0BAB1/HOLY_CORE_COURSE/3_perf_edition/hc_lib/readme.md

# HOLY CORE LIBRARY

This folder contains holy core's utilities drivers to do the very basic stuff. Mainly printing through UART and defining the current SoC depending on what you put on the FPGA.

You will need to build by simply running `make`.

Prerequisites:

- riscv toolchain (32 bits)
- make
