0BAB1/HOLY_CORE_COURSE/3_perf_edition/example_programs/hello_world_screen/readme.md

# Hello world (screen) BRH 12/25

This exmaple app is an exmaple to develop HOLY DRIVERS for a TFT 2.8" SPI screen.
