0BAB1/HOLY_CORE_COURSE/3_perf_edition/example_programs/hello_world_screen/tos.png

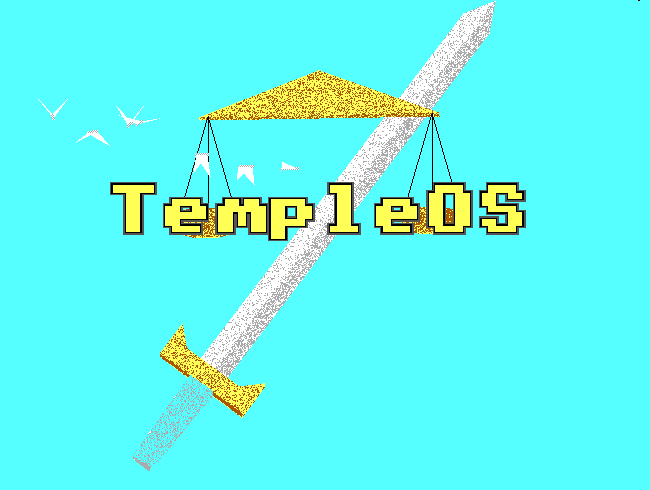
3_perf_edition/example_programs/hello_world_screen/tos.png
