0BAB1/HOLY_CORE_COURSE/user_docs/docs/images/Complete_single_cycle.png

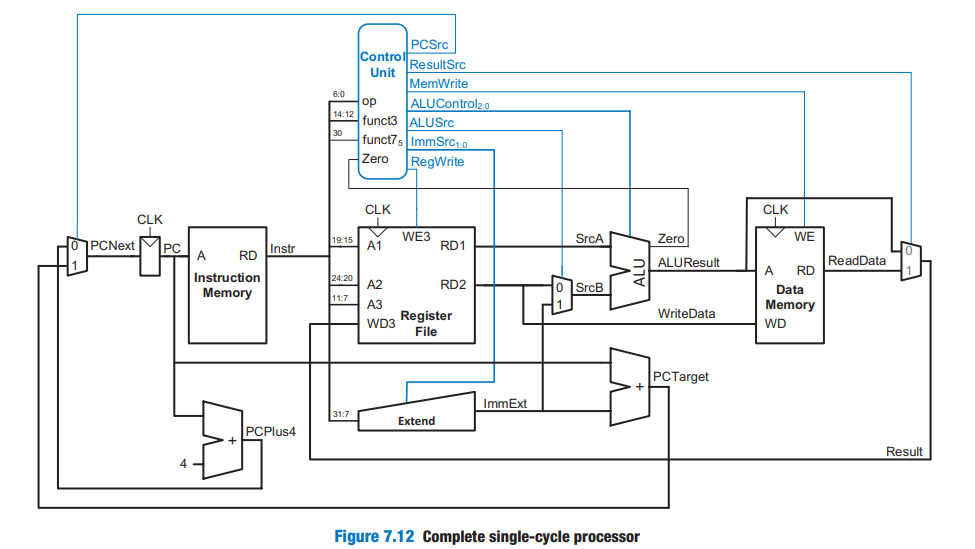
user_docs/docs/images/Complete_single_cycle.png
