0BAB1/HOLY_CORE_COURSE/user_docs/docs/images/f3_to_we_decode.png

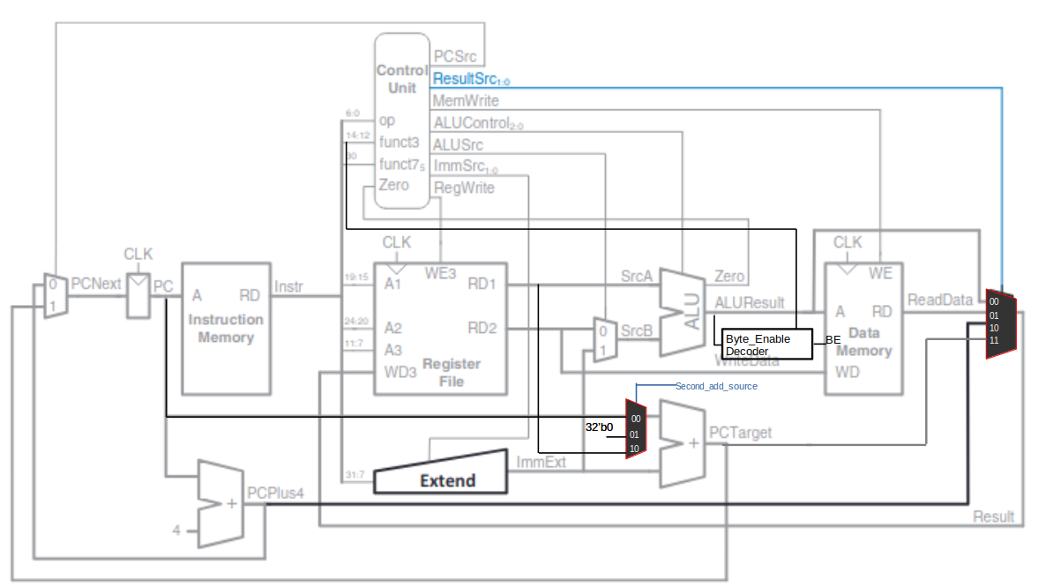
user_docs/docs/images/f3_to_we_decode.png
