0BAB1/HOLY_CORE_COURSE/user_docs/docs/images/holy_SoC.png

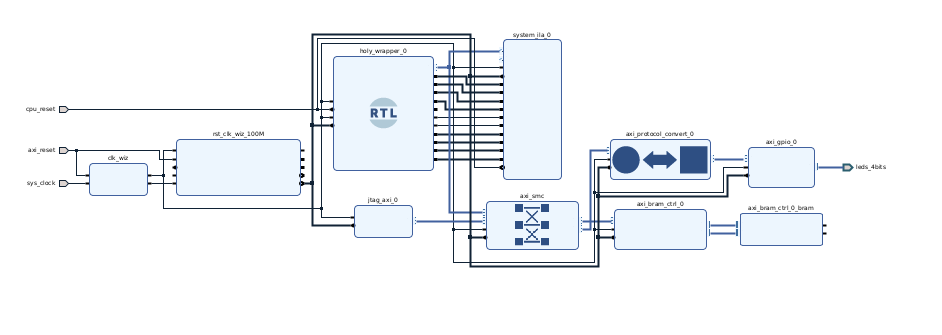
user_docs/docs/images/holy_SoC.png
