0BAB1/HOLY_CORE_COURSE/user_docs/docs/images/RV32_base_types.png

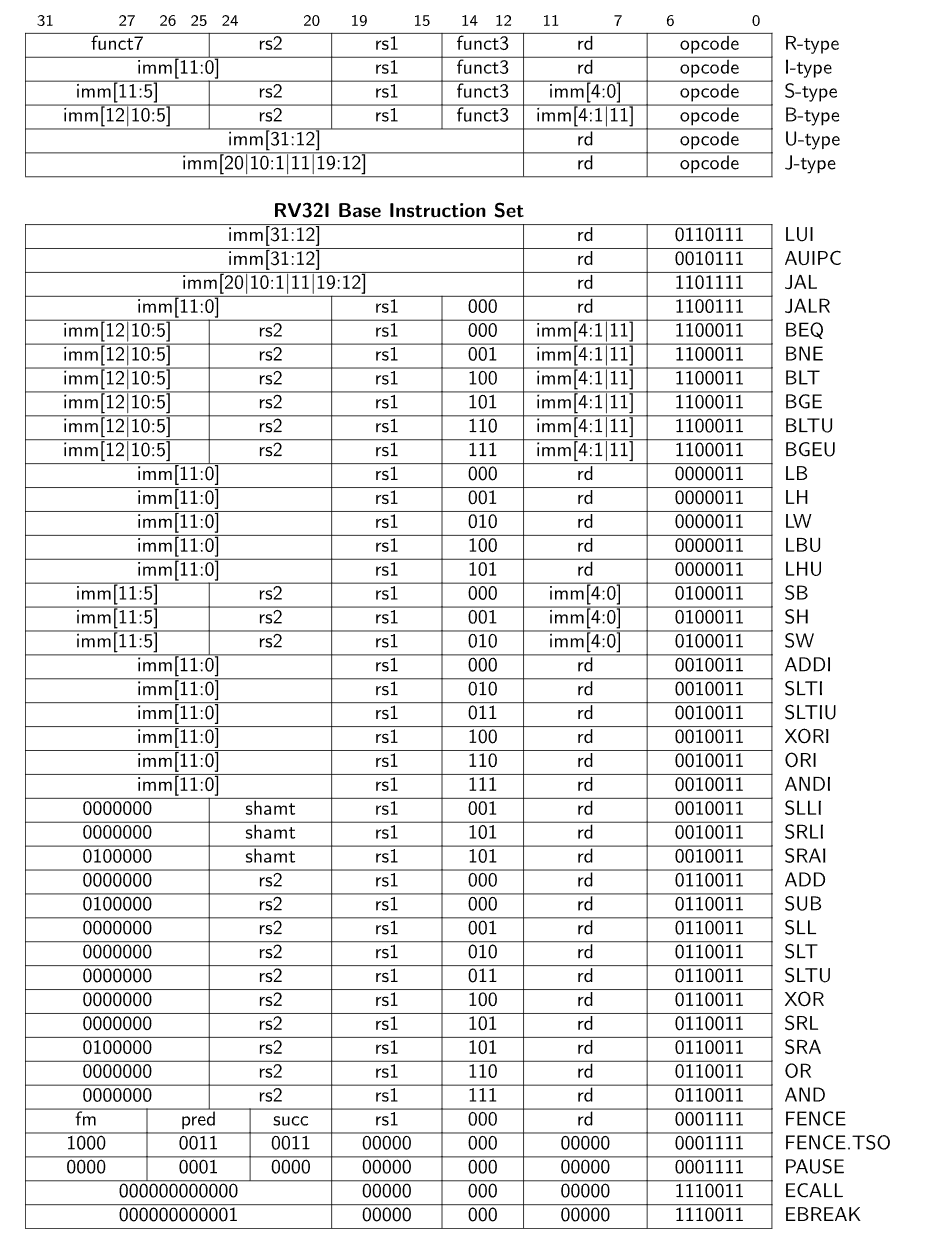
user_docs/docs/images/RV32_base_types.png
