0BAB1/HOLY_CORE_COURSE/user_docs/docs/images/todo.png

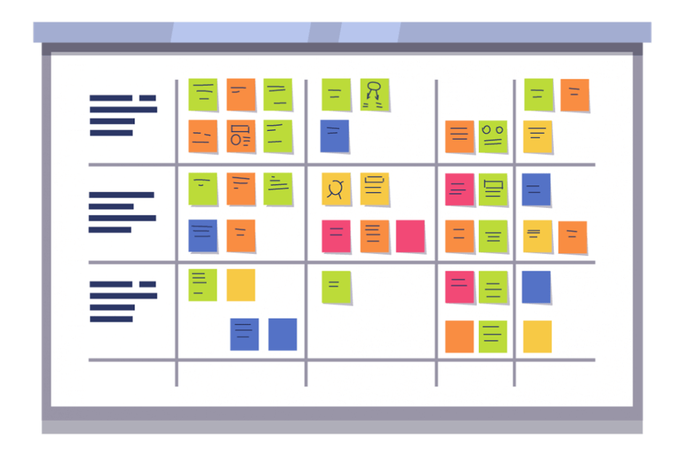
user_docs/docs/images/todo.png
