0BAB1/HOLY_CORE_COURSE/(threads)

Thread 6 (2025-01-05):

Errors in test run related to looping

gnudeep, 2025-01-05:
I want run test_runner.py on my Ubuntu 20.24 machine. When I try to run the TB I get the following error.

%Error-BLKLOOPINIT: /home/ubuntu/works/holy-core/HOLY_CORE_COURSE/single_cycle_edition/src/memory.sv:42:20: Unsupported: Delayed assignment to array inside for loops (non-delayed is ok - see docs)
   42 |             mem[i] <= 32'd0;
      |                    ^~
                    ... For error description see https://verilator.org/warn/BLKLOOPINIT?v=5.020
%Error: Exiting due to 1 error(s)
        ... See the manual at https://verilator.org/verilator_doc.html for more assistance.
Process 'perl' terminated with error 1

0BAB1, 2025-01-05:
Oh.. weird.

If you are working on the early stages of single cycle edition, using icarus verilog instead of verilator may do the trick.

To do so, replace the simulator in the cocotb makefile. Here is some guidance : https://docs.cocotb.org/en/stable/quickstart.html#creating-a-makefile

You can then switch back to verilator in the later stages of the single cycle edition.

Closed 2025-09-04.
