0BAB1/HOLY_CORE_COURSE/0_single_cycle_edition/src/control.sv

/*
* HOLY CORE CONTROL UNIT
*
* BRH 10/24
*
* Generic control unit. Refer to the schematics.
*/

`timescale 1ns/1ps

module control (
    input  logic [6:0] op,
    input  logic [2:0] func3,
    input  logic [6:0] func7,
    input  logic       alu_zero,
    input  logic       alu_last_bit,
    output logic [3:0] alu_control,
    output logic [2:0] imm_source,
    output logic       mem_write,
    output logic       reg_write,
    output logic       alu_source,
    output logic [1:0] write_back_source,
    output logic       pc_source,
    output logic [1:0] second_add_source
);

import holy_core_pkg::*;

/**
* MAIN DECODER
*/

logic [1:0] alu_op;
logic branch;
logic jump;

always_comb begin

    // Default assignments to prevent latch inference.
    reg_write = 1'b0;
    mem_write = 1'b0;
    alu_op = 2'b00;
    alu_source = 1'b0;
    imm_source = 3'b000;
    write_back_source = 2'b00;
    second_add_source = 2'b00;
    branch = 1'b0;
    jump = 1'b0;

    case (op)
        // I-type
        OPCODE_I_TYPE_LOAD : begin
            reg_write = 1'b1;
            imm_source = 3'b000;
            mem_write = 1'b0;
            alu_op = 2'b00;
            alu_source = 1'b1; //imm
            write_back_source =2'b01; //memory_read
            branch = 1'b0;
            jump = 1'b0;
        end
        // ALU I-type
        OPCODE_I_TYPE_ALU : begin
            imm_source = 3'b000;
            alu_source = 1'b1; //imm
            mem_write = 1'b0;
            alu_op = 2'b10;
            write_back_source = 2'b00; //alu_result
            branch = 1'b0;
            jump = 1'b0;
            // If we have a shift with a constant to handle, we have to invalidate writes for
            // instructions that does not have a well-formated immediate with "f7" and a 5bits shamt
            // ie :
            // - 7 upper bits are interpreted as a "f7", ony valid for a restricted slection tested below
            // - 5 lower as shamt (because max shift is 32bits and 2^5 = 32).
            if(func3 == F3_SLL)begin
                // slli only accept f7 7'b0000000
                reg_write = (func7 == F7_SLL_SRL) ? 1'b1 : 1'b0;
            end
            else if(func3 == F3_SRL_SRA)begin
                // srli only accept f7 7'b0000000
                // srai only accept f7 7'b0100000
                reg_write = (func7 == F7_SLL_SRL | func7 == F7_SRA) ? 1'b1 : 1'b0;
            end else begin
                reg_write = 1'b1;
            end
        end
        // S-Type
        OPCODE_S_TYPE : begin
            reg_write = 1'b0;
            imm_source = 3'b001;
            mem_write = 1'b1;
            alu_op = 2'b00;
            alu_source = 1'b1; //imm
            branch = 1'b0;
            jump = 1'b0;
        end
        // R-Type
        OPCODE_R_TYPE : begin
            reg_write = 1'b1;
            mem_write = 1'b0;
            alu_op = 2'b10;
            alu_source = 1'b0; //reg2
            write_back_source = 2'b00; //alu_result
            branch = 1'b0;
            jump = 1'b0;
        end
        // B-type
        OPCODE_B_TYPE : begin
            reg_write = 1'b0;
            imm_source = 3'b010;
            alu_source = 1'b0;
            mem_write = 1'b0;
            alu_op = 2'b01;
            branch = 1'b1;
            jump = 1'b0;
            second_add_source = 2'b00;
        end
        // J-type + JALR weird Hybrib
        OPCODE_J_TYPE, OPCODE_J_TYPE_JALR : begin
            reg_write = 1'b1;
            imm_source = 3'b011;
            mem_write = 1'b0;
            write_back_source = 2'b10; //pc_+4
            branch = 1'b0;
            jump = 1'b1;
            if(op[3]) begin// jal
                second_add_source = 2'b00;
                imm_source = 3'b011;
            end
            else if (~op[3]) begin // jalr
                second_add_source = 2'b10;
                imm_source = 3'b000;
            end
        end
        // U-type
        OPCODE_U_TYPE_LUI, OPCODE_U_TYPE_AUIPC : begin
            imm_source = 3'b100;
            mem_write = 1'b0;
            reg_write = 1'b1;
            write_back_source = 2'b11;
            branch = 1'b0;
            jump = 1'b0;
            case(op[5])
                1'b1 : second_add_source = 2'b01; // lui
                1'b0 : second_add_source = 2'b00; // auipc
            endcase
        end
        // EVERYTHING ELSE
        default: $display("Unknown/Unsupported OP CODE !");
    endcase
end

/**
* ALU DECODER
*/

always_comb begin

    // Default to ADD, prevents latch inference and avoids undefined alu_control value.
    alu_control = ALU_ADD;

    case (alu_op)
        // LW, SW
        ALU_OP_LOAD_STORE : alu_control = ALU_ADD;
        // R-Types, I-types
        ALU_OP_MATH : begin
            case (func3)
                // ADD (and later SUB with a different F7)
                F3_ADD_SUB : begin
                    // 2 scenarios here :
                    // - R-TYPE : either add or sub and we need to a check for that
                    // - I-Type : aadi -> we use add arithmetic
                    if(op == 7'b0110011) begin // R-type
                        alu_control = (func7 == F7_SUB)? ALU_SUB : ALU_ADD;
                    end else begin // I-Type
                        alu_control = ALU_ADD;
                    end
                end
                // AND
                F3_AND : alu_control = ALU_AND;
                // OR
                F3_OR : alu_control = ALU_OR;
                // SLT, SLTI
                F3_SLT: alu_control = ALU_SLT;
                // SLTU, SLTIU
                F3_SLTU : alu_control = ALU_SLTU;
                // XOR
                F3_XOR : alu_control = ALU_XOR;
                // SLL
                F3_SLL : alu_control = ALU_SLL;
                // SRL, SRA
                F3_SRL_SRA : begin
                    if(func7 == F7_SLL_SRL) begin
                        alu_control = ALU_SRL; // srl
                    end else if (func7 == F7_SRA) begin
                        alu_control = ALU_SRA; // sra
                    end
                end
            endcase
        end
        // BRANCHES
        ALU_OP_BRANCHES : begin
            case (func3)
                // BEQ, BNE
                F3_BEQ, F3_BNE : alu_control = ALU_SUB;
                // BLT, BGE
                F3_BLT, F3_BGE : alu_control = ALU_SLT;
                // BLTU, BGEU
                F3_BLTU, F3_BGEU : alu_control = ALU_SLTU;
                default : ;
            endcase
        end
        default : ;
    endcase
end

/**
* PC_Source
*/

logic assert_branch;

always_comb begin : branch_logic_decode
    case (func3)
        // BEQ
        F3_BEQ : assert_branch = alu_zero & branch;
        // BLT, BLTU
        F3_BLT, F3_BLTU : assert_branch = alu_last_bit & branch;
        // BNE
        F3_BNE : assert_branch = ~alu_zero & branch;
        // BGE, BGEU
        F3_BGE, F3_BGEU : assert_branch = ~alu_last_bit & branch;
        default : assert_branch = 1'b0;
    endcase
end

assign pc_source = assert_branch | jump;
    
endmodule
