0BAB1/HOLY_CORE_COURSE/3_perf_edition/src/holy_data_cache.sv

/** DATA CACHE MODULE
*
*   Author : BRH
*   Project : Holy Core Perf Edition
*   Description : A 2 way N sets, set-associative cache.
*                 Implementing AXI to request data from outside main memory.
*                 With a CPU handshake interface for OPTIMAL robusteness.
*                 The goal is to allow the user to connect its own memory on FPGA.
*                 It also supports non cachable ranges, which the use can set
*                 using CSRs.
*
*                 Goal is to implement cache as BRAM for optimal perfs
*                 Target : Xilinx FPGAs.
*
*   Created 11/25
*   Refactored: Separated ways into distinct 2D BRAMs for proper inference
*
*   10/26 - Flush fixes:
*     1. Flush write-back now gates the BRAM read on axi.wready, like the
*        normal eviction path (data was shifted / corrupted under AXI
*        back-pressure).
*     2. Flush only writes back lines that are VALID AND DIRTY (clean lines
*        were written back too, overwriting RAM changed behind the cache,
*        e.g. by a debugger load).
*     3. A flushed line is marked clean (dirty = 0) once its write response
*        is OK. With FLUSH_INVALIDATE = 1, the whole cache is also
*        invalidated when the flush completes.
*     4. Flush sequencing rewritten: every line is handled, then FLUSH_NEXT
*        advances or finishes (the last line could be written back twice).
*/

import holy_core_pkg::*;

module holy_data_cache #(
    parameter WORDS_PER_LINE = 16,
    parameter NUM_SETS = 8,
    // 0: flush = write back dirty lines, keep them valid (now clean)
    // 1: flush = write back dirty lines, then invalidate the whole cache
    parameter bit FLUSH_INVALIDATE = 1'b1,
    // MODIFYING THE FOLLOWING IS NOT SUPPORTED. 
    parameter NUM_WAYS = 2 
)(
    input logic clk,
    input logic rst_n,

    // CPU Interface
    input logic [31:0]  address,
    input logic [31:0]  write_data,
    // handshake
    input logic         req_valid,
    output logic        req_ready,
    input logic         req_write, // 0->R // 1->W
    input logic [3:0]   byte_enable,
    // read out
    output logic [31:0] read_data,
    output logic        read_valid,
    input logic         read_ack,

    // incomming CSR Orders
    input logic         csr_flush_order,

    // AXI Interface for external requests
    axi_if.master axi,

    // State informations for arbitrer
    output cache_state_t cache_state
);
    // =======================
    // CPU FRONTEND : HANDSHAKE CONTROL
    // =======================

    // Ready when idle (and not flushing)
    assign req_ready = (state == IDLE) && ~(csr_flush_order && ~csr_flushing_done);
    
    // flag accepted request for state transition
    logic req_accepted;
    assign req_accepted = req_valid && req_ready;

    // Request latch on miss: in case of a miss, the cache needs to remember 
    // the original missed request to fulfill it once it has moved data around
    logic                           pending_write, next_pending_write;
    logic [31:0]                    pending_addr, next_pending_addr;
    logic [31:0]                    pending_data, next_pending_data;
    logic [3:0]                     pending_be, next_pending_be;
    logic [SET_INDEX_BITS-1:0]      pending_set, next_pending_set;
    logic [WORD_OFFSET_BITS-1:0]    pending_word_offset, next_pending_word_offset;
    logic [TAG_BITS-1:0]            pending_tag, next_pending_tag;
    // Separate register to determine wether the upcomming READ OK results from a
    // missed request.
    logic                           pending_read, next_pending_read;

    // Hit latches are redundant, but kept because... yeah idk
    logic pending_hit_way, next_pending_hit_way;

    assign read_valid = (state == READ_OK);

    // =======================
    // ADDRESS BREAKDOWN
    // =======================
    // Address format: [TAG | SET_INDEX | WORD_OFFSET | BYTE_OFFSET]
    // 32 bits total:
    //   - Byte offset: 2 bits (4 bytes per word)
    //   - Word offset: 4 bits (16 words per line)
    //   - Set index: 3 bits (8 sets)
    //   - Tag: 23 bits (remaining)
    
    localparam WAYS_BITS = $clog2(NUM_WAYS);
    localparam BYTE_OFFSET_BITS = 2;
    localparam WORD_OFFSET_BITS = $clog2(WORDS_PER_LINE);
    localparam SET_INDEX_BITS   = $clog2(NUM_SETS);
    localparam TAG_BITS         = 32 - BYTE_OFFSET_BITS - WORD_OFFSET_BITS - SET_INDEX_BITS;

    // warning free markers for loops
    localparam LAST_WORD = WORDS_PER_LINE - 1;
    localparam LAST_SET = NUM_SETS - 1;
    
    wire [TAG_BITS-1:0]         req_tag;
    wire [SET_INDEX_BITS-1:0]   req_set;
    wire [WORD_OFFSET_BITS-1:0] req_word_offset;
    
    assign req_tag         = address[31:31-TAG_BITS+1];
    assign req_set         = address[BYTE_OFFSET_BITS+WORD_OFFSET_BITS +: SET_INDEX_BITS];
    assign req_word_offset = address[BYTE_OFFSET_BITS +: WORD_OFFSET_BITS];

    // =======================
    // BRAM PORTS SIGNALS
    // =======================
    
    // Enable signals for each way
    logic bram_we_way0, bram_we_way1;
    logic bram_re_way0, bram_re_way1;
    // to flag when read recieve is fully over
    logic bram_write_complete, next_bram_write_complete;
    
    // Address signals for BRAM access
    logic [SET_INDEX_BITS-1:0]   bram_set_addr;
    logic [WORD_OFFSET_BITS-1:0] bram_word_addr;
    
    // R/W data for BRAMs
    logic [31:0] bram_wdata;
    logic [3:0]  bram_be;
    logic [31:0] rdata_way0, rdata_way1;
    logic [31:0] bram_rdata;

    // =======================
    // Data slots declaration - SEPARATED WAYS FOR BRAM INFERENCE
    // =======================

    // Cache storage: 2 separate BRAMs, one per way
    // Each BRAM: NUM_SETS × WORDS_PER_LINE words

    // Way 0 BRAM
    cache_bram_way #(
    .NUM_SETS(NUM_SETS),
    .WORDS_PER_LINE(WORDS_PER_LINE)
    ) bram_way0 (
        .clk(clk),
        .we(bram_we_way0),
        .be(bram_be),
        .set_addr(bram_set_addr),
        .word_addr(bram_word_addr),
        .wdata(bram_wdata),
        .re(bram_re_way0),
        .rdata(rdata_way0)
    );

    // Way 1 BRAM
    cache_bram_way #(
    .NUM_SETS(NUM_SETS),
    .WORDS_PER_LINE(WORDS_PER_LINE)
    ) bram_way1 (
        .clk(clk),
        .we(bram_we_way1),
        .be(bram_be),
        .set_addr(bram_set_addr),
        .word_addr(bram_word_addr),
        .wdata(bram_wdata),
        .re(bram_re_way1),
        .rdata(rdata_way1)
    );

    // Metadata remains as before
    logic [TAG_BITS-1:0] cache_tags  [NUM_WAYS-1:0][NUM_SETS-1:0];
    logic                cache_valid [NUM_WAYS-1:0][NUM_SETS-1:0];
    logic                cache_dirty [NUM_WAYS-1:0][NUM_SETS-1:0];

    // lru = least recently used, decides which way will 
    logic lru_bits [NUM_SETS-1:0];

    // Signals for cache access
    logic hit_way0, hit_way1, hit;
    logic [NUM_WAYS-1:0] way_hit;
    logic hit_way_select;
    logic victim_way;

    // Control signals
    logic csr_flushing, next_csr_flushing;
    logic csr_flushing_done, next_csr_flushing_done;

    // =======================
    // HIT DETECTION COMB
    // =======================

    assign hit_way0 = cache_valid[0][req_set] && (cache_tags[0][req_set] == req_tag);
    assign hit_way1 = cache_valid[1][req_set] && (cache_tags[1][req_set] == req_tag);
    assign hit = hit_way0 || hit_way1;
    assign hit_way_select = hit_way1; // 0 if way0 hits, 1 if way1 hits

    // Victim selection for replacement (use LRU)
    assign victim_way = lru_bits[req_set];

    // =======================
    // CACHE LOGIC
    // =======================
    cache_state_t state, next_state;

    // Current way being serviced
    logic current_way, next_current_way;
    // flush indicators
    logic [WAYS_BITS-1:0]           flush_way, next_flush_way;
    logic [SET_INDEX_BITS-1:0]      flush_set, next_flush_set;

    // Word pointer for burst transfers
    logic [WORD_OFFSET_BITS-1:0]    word_ptr, next_word_ptr;
    // This is a quick temp fix to keep rack of words sent during SENDING W DATA
    // state, I can't use word ptr bcause it will overflow...
    logic [WORD_OFFSET_BITS:0]      words_sent, next_words_sent;

    // Cache valid/dirty next state
    logic [TAG_BITS-1:0] next_cache_tags  [NUM_WAYS-1:0][NUM_SETS-1:0];
    logic next_cache_valid  [NUM_WAYS-1:0][NUM_SETS-1:0];
    logic next_cache_dirty  [NUM_WAYS-1:0][NUM_SETS-1:0];
    logic next_lru_bits     [NUM_SETS-1:0];

    // bram_write_complete registers
    always_ff @(posedge clk) begin
        if (~rst_n) begin
            bram_write_complete <= 0;
        end else begin
            bram_write_complete <= next_bram_write_complete;
        end
    end

    // Mux the read data
    // We want to read when :
    //   - we are reading (read OK)
    //   - sending back data on a write back (flush or missed request)
    always_comb begin
        bram_rdata = '0;
        if(state == READ_OK) begin
            if(~pending_read) begin
                // Read was a HIT
                bram_rdata = pending_hit_way ? rdata_way1 : rdata_way0;
            end else begin
                // Read was a MISS
                bram_rdata = current_way ? rdata_way1 : rdata_way0;
            end
        end else if(state == SENDING_WRITE_DATA) begin
            if(csr_flushing) begin
                bram_rdata = flush_way ? rdata_way1 : rdata_way0;
            end else begin
                bram_rdata = current_way ? rdata_way1 : rdata_way0;
            end
        end
    end
    
    // =======================
    // BRAM CONTROL SIGNALS - ACTIVE SOURCE SELECTION
    // =======================
    
    // Determine BRAM write enables based on current operation
    always_comb begin
        // Defaults
        bram_we_way0 = 1'b0;
        bram_we_way1 = 1'b0;
        bram_re_way0 = 1'b0;
        bram_re_way1 = 1'b0;
        bram_be = 4'b0;
        bram_set_addr = req_set;
        bram_word_addr = req_word_offset;
        bram_wdata = write_data;
        
        //---------------------------
        // Write HIT on IDLE state
        //---------------------------
        if (state == IDLE && hit && req_write && req_accepted) begin
            bram_set_addr = req_set;
            bram_word_addr = req_word_offset;
            bram_wdata = write_data;
            bram_be = byte_enable;
            bram_we_way0 = hit_way0;
            bram_we_way1 = hit_way1;
        end
        
        //---------------------------
        // AXI cache line fill
        //---------------------------
        else if (state == RECEIVING_READ_DATA && axi.rvalid && axi.rready) begin
            bram_set_addr = pending_set;
            bram_word_addr = word_ptr;
            bram_wdata = axi.rdata;
            bram_be = 4'b1111;
            bram_we_way0 = (current_way == 1'b0);
            bram_we_way1 = (current_way == 1'b1);
        end

        //---------------------------
        // AXI write back : prefetch first data while sending request
        //---------------------------
        else if (state == SENDING_WRITE_REQ) begin
            if (csr_flushing) begin
                bram_set_addr = flush_set;
                bram_word_addr = '0;
                bram_re_way0 = ~flush_way;
                bram_re_way1 = flush_way;
            end else begin
                bram_set_addr = pending_set;
                bram_word_addr = '0;
                bram_re_way0 = ~current_way;
                bram_re_way1 = current_way;
            end
        end

        //---------------------------
        // AXI write back : we need to read data from BRAM to send it !
        // The BRAM read is 1 cycle late vs word_ptr: only advance the readout
        // when the slave accepts the current word (both paths).
        //---------------------------
        else if (state == SENDING_WRITE_DATA) begin
            if (csr_flushing) begin
                // FIX : same back-pressure gating as the eviction path
                bram_set_addr = flush_set;
                bram_word_addr = word_ptr;
                bram_re_way0 = axi.wready ? ~flush_way : 1'b0;
                bram_re_way1 = axi.wready ?  flush_way : 1'b0;
            end else begin
                bram_set_addr = pending_set;
                bram_word_addr = word_ptr;
                bram_re_way0 = axi.wready ? ~current_way : 1'b0;
                bram_re_way1 = axi.wready ?  current_way : 1'b0;
            end
        end
        
        // Fulfill pending write after cache line fill
        else if (state == FULFILL_PENDING_WRITE) begin
            bram_set_addr = pending_set;
            bram_word_addr = pending_word_offset;
            bram_wdata = pending_data;
            bram_be = pending_be;
            bram_we_way0 = (current_way == 1'b0);
            bram_we_way1 = (current_way == 1'b1);
        end
        
        // Read address setup
        if (next_state == READ_OK) begin
            if(hit && ~pending_read) begin
                bram_re_way0 = hit_way0;
                bram_re_way1 = hit_way1;
            end else begin
                bram_re_way0 = (current_way == 1'b0);
                bram_re_way1 = (current_way == 1'b1);
            end

            if (hit && ~pending_read) begin
                bram_set_addr = req_set;
                bram_word_addr = req_word_offset;
            end else begin
                bram_set_addr = pending_set;
                bram_word_addr = pending_word_offset;
            end
        end
    end

    // =======================
    // MAIN CLOCK DRIVEN SEQ LOGIC (METADATA ONLY)
    // =======================
    
    always_ff @(posedge clk) begin
        if (~rst_n) begin
            csr_flushing <= 1'b0;
            csr_flushing_done <= 1'b0;
            // flush reg
            flush_way <= 0;
            flush_set <= 0;
            
            // Initialize all cache lines as invalid
            for (int w = 0; w < NUM_WAYS; w++) begin
                for (int s = 0; s < NUM_SETS; s++) begin
                    cache_valid[w][s] <= 1'b0;
                    cache_dirty[w][s] <= 1'b0;
                    cache_tags[w][s] <= '0;
                end
            end
            
            // Initialize LRU bits
            for (int s = 0; s < NUM_SETS; s++) begin
                lru_bits[s] <= 1'b0;
            end

            // missed requests latches
            pending_write <= 1'b0;
            pending_addr <= '0;
            pending_data <= '0;
            pending_be <= 4'b0;
            pending_set <= '0;
            pending_word_offset <= '0;
            pending_tag <= '0;
            pending_read <= 1'b0;
            pending_hit_way <= 1'b0;
            
        end else begin
            // DEFAULT REG LATCHES
            // cache metadata
            for (int w = 0; w < NUM_WAYS; w++) begin
                for (int s = 0; s < NUM_SETS; s++) begin
                    cache_tags[w][s]  <= next_cache_tags[w][s];
                    cache_valid[w][s] <= next_cache_valid[w][s];
                    cache_dirty[w][s] <= next_cache_dirty[w][s];
                end
            end

            for (int s = 0; s < NUM_SETS; s++) begin
                lru_bits[s] <= next_lru_bits[s];
            end

            
            csr_flushing <= next_csr_flushing;
            csr_flushing_done <= next_csr_flushing_done;

            // flush reg
            flush_way <= next_flush_way;
            flush_set <= next_flush_set;

            // pending request latches
            pending_write <= next_pending_write;
            pending_addr  <= next_pending_addr;
            pending_data <= next_pending_data;
            pending_be <= next_pending_be;
            pending_set <= next_pending_set;
            pending_word_offset <= next_pending_word_offset;
            pending_tag <= next_pending_tag;
            pending_read <= next_pending_read;
            pending_hit_way <= next_pending_hit_way;

            // Handle dirty flag update on cache hit write
            if (hit && req_write && req_accepted && state == IDLE) begin
                if (hit_way0) begin
                    cache_dirty[0][req_set] <= 1'b1;
                    lru_bits[req_set] <= 1'b1; // Mark way 1 as LRU
                end else begin
                    cache_dirty[1][req_set] <= 1'b1;
                    lru_bits[req_set] <= 1'b0; // Mark way 0 as LRU
                end
            end
            
            // Update LRU on read hit (when request is accepted)
            if (hit && ~req_write && req_accepted && state == IDLE) begin
                lru_bits[req_set] <= ~hit_way_select;
            end
        end
    end

    // =======================
    // AXI FSM STATES
    // =======================

    // SEQ LOGIC
    always_ff @(posedge clk) begin
        if (~rst_n) begin
            state <= IDLE;
            word_ptr <= '0;
            words_sent <= '0;
            current_way <= 1'b0;
        end else begin
            state <= next_state;
            word_ptr <= next_word_ptr;
            current_way <= next_current_way;
            words_sent <= next_words_sent;
        end
    end

    // STATE TRANSITION / AXI MASTER LOGIC
    always_comb begin
        // State transition defaults
        next_state = state;
        next_current_way = current_way;
        next_word_ptr = word_ptr;
        next_words_sent = 0;
        
        // flush control
        next_csr_flushing = csr_flushing;
        next_csr_flushing_done = csr_flushing_done ? csr_flush_order : csr_flushing_done;
        next_flush_set = flush_set;
        next_flush_way = flush_way;
        
        // cache metadata
        next_cache_tags = cache_tags;
        next_cache_valid = cache_valid;
        next_cache_dirty = cache_dirty;
        next_lru_bits = lru_bits;
        
        // pending request latches
        next_pending_write = pending_write;
        next_pending_addr = pending_addr;
        next_pending_data = pending_data;
        next_pending_be = pending_be;
        next_pending_set = pending_set;
        next_pending_word_offset = pending_word_offset;
        next_pending_tag = pending_tag;
        next_pending_read = pending_read;
        next_pending_hit_way = pending_hit_way;

        // AXI DEFAULT
        axi.wlast = 0;
        axi.arvalid = 0;
        axi.awvalid = 0;
        axi.wvalid = 0;
        axi.bready = 0;
        axi.rready = 0;
        axi.wdata = '0;
        axi.araddr = 32'h0;
        axi.awaddr = 32'h0;

        // MISC DEFAULTS
        cache_state = state;
        read_data = 32'h0;
        next_bram_write_complete = 0;

        case (state)
            IDLE: begin
                // INIT FLUSHING PROCEDURE
                // Walk every (way, set) starting at (0, 0). Only VALID AND DIRTY
                // lines are written back; FLUSH_NEXT advances over the others.
                if (csr_flush_order && ~csr_flushing_done) begin
                    next_csr_flushing = 1'b1;
                    next_flush_set = '0;
                    next_flush_way = '0;

                    if (cache_valid[0][0] && cache_dirty[0][0]) begin
                        next_state = SENDING_WRITE_REQ;
                    end else begin
                        next_state = FLUSH_NEXT;
                    end
                end
                
                // ACCEPT MISS
                else if (req_accepted && ~hit) begin
                    // Cache miss on accepted request - determine victim way
                    next_current_way = victim_way;

                    // Latch the entire request for later fulfillment
                    next_pending_write = req_write;
                    next_pending_read = ~req_write;
                    next_pending_addr = address;
                    next_pending_data = write_data;
                    next_pending_be = byte_enable;
                    next_pending_set = req_set;
                    next_pending_word_offset = req_word_offset;
                    next_pending_tag = req_tag;
                    
                    // Check if victim line is dirty
                    if (cache_valid[victim_way][req_set] && cache_dirty[victim_way][req_set]) begin
                        next_state = SENDING_WRITE_REQ;
                    end else begin
                        next_state = SENDING_READ_REQ;
                    end
                    next_word_ptr = '0;
                end
                
                // ACCEPT HIT (READ)
                else if (hit && ~req_write && req_accepted) begin
                    next_state = READ_OK;
                    next_pending_hit_way = hit_way_select;
                end
            end
            
            SENDING_WRITE_REQ: begin
                // Write back dirty cache line
                if (csr_flushing) begin
                    axi.awaddr = {cache_tags[flush_way][flush_set], flush_set, {WORD_OFFSET_BITS{1'b0}}, 2'b00};
                end else begin
                    axi.awaddr = {cache_tags[current_way][pending_set], pending_set, {WORD_OFFSET_BITS{1'b0}}, 2'b00};
                end
                
                if (axi.awready) begin
                    next_state = SENDING_WRITE_DATA;
                    // we start at 1 because word 0 is being pre fetched
                    next_word_ptr = 1;
                end

                axi.awvalid = 1'b1;
            end

            SENDING_WRITE_DATA: begin
                next_words_sent = words_sent;
                axi.wdata = bram_rdata;
                axi.wvalid = 1'b1;
                // data is flagged as ready to send once BRAM outputs its data
                if (axi.wready) begin
                    next_word_ptr = word_ptr + 1;
                    next_words_sent = words_sent + 1;
                end
                
                // watch out ! there is a 1 cycle delay between word_ptr and the actual
                // data value associated (bram).
                if (words_sent == LAST_WORD[WORD_OFFSET_BITS:0]) begin
                    axi.wlast = 1'b1;
                    if (axi.wready) begin
                        next_state = WAITING_WRITE_RES;
                    end
                end
            end

            WAITING_WRITE_RES: begin
                if (axi.bvalid && (axi.bresp == 2'b00)) begin
                    if (csr_flushing) begin
                        // RAM now holds this line: it is clean.
                        // FLUSH_NEXT moves to the next line or ends the flush.
                        next_cache_dirty[flush_way][flush_set] = 1'b0;
                        next_state = FLUSH_NEXT;
                    end else begin
                        // Normal write-back complete, now fetch the data
                        next_state = SENDING_READ_REQ;
                    end
                end else if (axi.bvalid && (axi.bresp!= 2'b00)) begin
                    $display("ERROR: AXI write response error");
                    $display("TODO : cause a trap");
                end

                axi.bready = 1'b1;
            end

            FLUSH_NEXT: begin
                // The line at (flush_way, flush_set) is done (written back or
                // did not need it). Finish, or advance and decide for the next.
                if ((flush_way == 1'b1) && (flush_set == LAST_SET[SET_INDEX_BITS-1:0])) begin
                    // Last line of the last way: flush over
                    next_state = IDLE;
                    next_csr_flushing = 1'b0;
                    next_csr_flushing_done = 1'b1;

                    // Optional: drop every line (all dirty data is in RAM now)
                    if (FLUSH_INVALIDATE) begin
                        for (int w = 0; w < NUM_WAYS; w++) begin
                            for (int s = 0; s < NUM_SETS; s++) begin
                                next_cache_valid[w][s] = 1'b0;
                                next_cache_dirty[w][s] = 1'b0;
                            end
                        end
                    end
                end else begin
                    // Advance the (way, set) pointer
                    if (flush_set == LAST_SET[SET_INDEX_BITS-1:0]) begin
                        next_flush_way = flush_way + 1'b1;
                        next_flush_set = '0;
                    end else begin
                        next_flush_set = flush_set + 1'b1;
                    end

                    // Write the next line back only if it is valid AND dirty
                    if (cache_valid[next_flush_way][next_flush_set] &&
                        cache_dirty[next_flush_way][next_flush_set]) begin
                        next_state = SENDING_WRITE_REQ;
                    end else begin
                        next_state = FLUSH_NEXT;
                    end
                end
            end

            SENDING_READ_REQ: begin
                axi.araddr = {pending_tag, pending_set, {WORD_OFFSET_BITS{1'b0}}, 2'b00};
                
                if (axi.arready) begin
                    next_state = RECEIVING_READ_DATA;
                    next_word_ptr = '0;
                end

                axi.arvalid = 1'b1;
            end

            RECEIVING_READ_DATA: begin
                if (axi.rvalid) begin
                    next_word_ptr = word_ptr + 1;
                    next_bram_write_complete = 0;
                    
                    if (axi.rlast) begin
                        // Depending on what caused the miss, we react differently
                        if(pending_write) begin
                            next_state = FULFILL_PENDING_WRITE;
                        end else begin
                            // (this miss was a read...)
                            // We have to wait for the bram write to be fully over by adding a 1 cycle delay
                            // thru "bram_write_complete" to make sure read data was written internally
                            next_bram_write_complete = 1;
                        end
                    end
                end

                if(bram_write_complete) begin
                    // update cache metadata
                    next_cache_tags[current_way][pending_set] = pending_tag;
                    next_cache_valid[current_way][pending_set] = 1'b1;
                    next_lru_bits[pending_set] = ~current_way;
                    // state transition
                    next_state = READ_OK;
                    next_cache_dirty[current_way][pending_set] = 1'b0;
                end

                axi.rready = 1'b1;
            end

            READ_OK: begin
                // Signal output data as valid
                if(read_ack) begin
                    next_state = IDLE;
                    // reset pending read request
                    next_pending_read = 0;
                end
                
                // Set read data from appropriate way
                read_data = bram_rdata;
            end

            FULFILL_PENDING_WRITE : begin
                // The miss was caused by a write
                // BRAM control logic will write the data when this state is active
                next_pending_write = 1'b0;
                next_state = IDLE;
                
                // Update cache metadata for the write
                next_cache_tags[current_way][pending_set] = pending_tag;
                next_cache_dirty[current_way][pending_set] = 1'b1;
                next_cache_valid[current_way][pending_set] = 1'b1;
                next_lru_bits[pending_set] = ~current_way;
            end
            
            default: begin
                $display("ERROR: Invalid cache FSM state");
            end
        endcase
    end

    // =======================
    // MISC SIGNALS
    // =======================

    // AXI CONSTANTS
    // ---------------
    // ADDRESS CHANNELS
    assign axi.awlen = WORDS_PER_LINE - 1;  // 16 words per burst
    assign axi.awsize = 3'b010;              // 4 bytes per transfer
    assign axi.awburst = 2'b01;              // INCR mode
    assign axi.arlen = WORDS_PER_LINE - 1;  // 16 words per burst
    assign axi.arsize = 3'b010;              // 4 bytes per transfer
    assign axi.arburst = 2'b01;              // INCR mode
    assign axi.awid = 4'b0000;
    assign axi.arid = 4'b0000;
    // DATA CHANNELS
    assign axi.wstrb = 4'b1111;              // Full word writes

endmodule


module cache_bram_way #(
    parameter NUM_SETS = 4,
    parameter WORDS_PER_LINE = 16,
    parameter DATA_WIDTH = 32
)(
    input  wire        clk,
    
    // Write port
    input  wire        we,
    input  wire [3:0]  be,
    input  wire [$clog2(NUM_SETS)-1:0]       set_addr,
    input  wire [$clog2(WORDS_PER_LINE)-1:0] word_addr,
    input  wire [DATA_WIDTH-1:0]             wdata,
    
    // Read port
    input  wire        re,
    output reg  [DATA_WIDTH-1:0]             rdata
);

    localparam DEPTH = NUM_SETS * WORDS_PER_LINE;
    localparam ADDR_WIDTH = $clog2(DEPTH);

    // FLATTENED 1D array - this is what Vivado wants for BRAM
    (* ram_style = "block" *) reg [DATA_WIDTH-1:0] mem [0:DEPTH-1];

    // Combined address
    wire [ADDR_WIDTH-1:0] addr = {set_addr, word_addr};

    // Simple dual-port: sync write, sync read
    always @(posedge clk) begin
        // Write with byte enables
        if (we) begin
            if (be[0]) mem[addr][ 7: 0] <= wdata[ 7: 0];
            if (be[1]) mem[addr][15: 8] <= wdata[15: 8];
            if (be[2]) mem[addr][23:16] <= wdata[23:16];
            if (be[3]) mem[addr][31:24] <= wdata[31:24];
        end
        
        // Registered read
        if (re) begin
            rdata <= mem[addr];
        end
    end

endmodule
