0BAB1/HOLY_CORE_COURSE/3_performance_edition/tb/holy_data_cache/axi_translator.sv

/* AXI_TRANSLATOR
*
* BRH 11/24
*
* This wrapper module instantiates the cache and routes the AXI interface as discrete Verilog signals for cocotb
*/


module axi_translator (
    // ==========
    // AXI FULL
    // ==========
    
    // Cpu Clock and Reset
    input  logic                     clk,
    input  logic                     rst_n,

    // Axi Clock
    input  logic                     aclk,

    // Write Address Channel
    output logic [3:0]               axi_awid,
    output logic [31:0]              axi_awaddr,
    output logic [7:0]               axi_awlen,
    output logic [2:0]               axi_awsize,
    output logic [1:0]               axi_awburst,
    output logic                     axi_awvalid,
    input  logic                     axi_awready,

    // Write Data Channel
    output logic [31:0]              axi_wdata, 
    output logic [3:0]               axi_wstrb,
    output logic                     axi_wlast,
    output logic                     axi_wvalid,
    input  logic                     axi_wready,

    // Write Response Channel
    input  logic [3:0]               axi_bid,
    input  logic [1:0]               axi_bresp,
    input  logic                     axi_bvalid,
    output logic                     axi_bready,

    // Read Address Channel
    output logic [3:0]               axi_arid,
    output logic [31:0]              axi_araddr,
    output logic [7:0]               axi_arlen,
    output logic [2:0]               axi_arsize,
    output logic [1:0]               axi_arburst,
    output logic                     axi_arvalid,
    input  logic                     axi_arready,

    // Read Data Channel
    input  logic [3:0]               axi_rid,
    input  logic [31:0]              axi_rdata,
    input  logic [1:0]               axi_rresp,
    input  logic                     axi_rlast,
    input  logic                     axi_rvalid,
    output logic                     axi_rready,

    // ==========
    // AXI LITE
    // ==========

    // AXI-Lite Write Address Channel
    output logic [31:0]              axi_lite_awaddr,
    output logic                     axi_lite_awvalid,
    input  logic                     axi_lite_awready,

    // AXI-Lite Write Data Channel
    output logic [31:0]              axi_lite_wdata,
    output logic [3:0]               axi_lite_wstrb,
    output logic                     axi_lite_wvalid,
    input  logic                     axi_lite_wready,

    // AXI-Lite Write Response Channel
    input  logic [1:0]               axi_lite_bresp,
    input  logic                     axi_lite_bvalid,
    output logic                     axi_lite_bready,

    // AXI-Lite Read Address Channel
    output logic [31:0]              axi_lite_araddr,
    output logic                     axi_lite_arvalid,
    input  logic                     axi_lite_arready,

    // AXI-Lite Read Data Channel
    input  logic [31:0]              axi_lite_rdata,
    input  logic [1:0]               axi_lite_rresp,
    input  logic                     axi_lite_rvalid,
    output logic                     axi_lite_rready,

    // ==========
    // CPU Interface
    // ==========
    input logic [31:0]               cpu_address,
    input logic [31:0]               cpu_write_data,
    input logic                      cpu_read_enable,
    input logic                      cpu_write_enable,
    input logic [3:0]                cpu_byte_enable,
    output logic [31:0]              cpu_read_data,
    output logic                     cpu_cache_stall
);

    import holy_core_pkg::*;

    // ==========
    // AXI FULL
    // ==========

    // Declare the AXI master interface for the cache
    axi_if axi_master_intf();
    logic [6:0] set_ptr_out;

    // Write Address Channel
    assign axi_awid       = axi_master_intf.awid;
    assign axi_awaddr     = axi_master_intf.awaddr;
    assign axi_awlen      = axi_master_intf.awlen;
    assign axi_awsize     = axi_master_intf.awsize;
    assign axi_awburst    = axi_master_intf.awburst;
    assign axi_awvalid    = axi_master_intf.awvalid;
    assign axi_master_intf.awready = axi_awready;


    // Write Data Channel
    assign axi_wdata   = axi_master_intf.wdata;
    assign axi_wstrb   = axi_master_intf.wstrb;
    assign axi_wlast   = axi_master_intf.wlast;
    assign axi_wvalid  = axi_master_intf.wvalid;
    assign axi_master_intf.wready = axi_wready;

    // Write Response Channel
    assign axi_master_intf.bid    = axi_bid;
    assign axi_master_intf.bresp  = axi_bresp;
    assign axi_master_intf.bvalid = axi_bvalid;
    assign axi_bready             = axi_master_intf.bready;

    // Read Address Channel
    assign axi_arid    = axi_master_intf.arid;
    assign axi_araddr  = axi_master_intf.araddr;
    assign axi_arlen   = axi_master_intf.arlen;
    assign axi_arsize  = axi_master_intf.arsize;
    assign axi_arburst = axi_master_intf.arburst;
    assign axi_arvalid = axi_master_intf.arvalid;
    assign axi_master_intf.arready = axi_arready;

    // Read Data Channel
    assign axi_master_intf.rid    = axi_rid;
    assign axi_master_intf.rdata  = axi_rdata;
    assign axi_master_intf.rresp  = axi_rresp;
    assign axi_master_intf.rlast  = axi_rlast;
    assign axi_master_intf.rvalid = axi_rvalid;
    assign axi_rready             = axi_master_intf.rready;

    // ==========
    // AXI LITE
    // ==========

    // Declare AXI Lite interface
    axi_lite_if axi_lite_master_intf();

    // Write Address Channel
    assign axi_lite_awaddr  = axi_lite_master_intf.awaddr;
    assign axi_lite_awvalid = axi_lite_master_intf.awvalid;
    assign axi_lite_master_intf.awready = axi_lite_awready;

    // Write Data Channel
    assign axi_lite_wdata  = axi_lite_master_intf.wdata;
    assign axi_lite_wstrb  = axi_lite_master_intf.wstrb;
    assign axi_lite_wvalid = axi_lite_master_intf.wvalid;
    assign axi_lite_master_intf.wready = axi_lite_wready;

    // Write Response Channel
    assign axi_lite_master_intf.bresp  = axi_lite_bresp;
    assign axi_lite_master_intf.bvalid = axi_lite_bvalid;
    assign axi_lite_bready             = axi_lite_master_intf.bready;

    // Read Address Channel
    assign axi_lite_araddr  = axi_lite_master_intf.araddr;
    assign axi_lite_arvalid = axi_lite_master_intf.arvalid;
    assign axi_lite_master_intf.arready = axi_lite_arready;

    // Read Data Channel
    assign axi_lite_master_intf.rdata  = axi_lite_rdata;
    assign axi_lite_master_intf.rresp  = axi_lite_rresp;
    assign axi_lite_master_intf.rvalid = axi_lite_rvalid;
    assign axi_lite_rready             = axi_lite_master_intf.rready;

    // dummy wireto shut verilator down
    cache_state_t cache_state;

    // Instantiate the cache module
    /* verilator lint_off PINMISSING */
    holy_data_cache #(
    ) cache_system (
        .clk(clk), 
        .rst_n(rst_n),

        // AXI Master Interface
        .axi(axi_master_intf),

        // AXI LITE Master Interface
        .axi_lite(axi_lite_master_intf),

        // CPU Interface
        .address(cpu_address),
        .write_data(cpu_write_data),
        .read_enable(cpu_read_enable),
        .write_enable(cpu_write_enable),
        .byte_enable(cpu_byte_enable),
        .read_data(cpu_read_data),
        .cache_stall(cpu_cache_stall),
        .cache_state(cache_state),

        // debug interface
        .set_ptr_out(set_ptr_out)
    );
    /* verilator lint_on PINMISSING */

endmodule
