0BAB1/HOLY_CORE_COURSE/3_perf_edition/packages/holy_core_pkg.sv

/** HOLY CORE PACKAGE
*
* This file contains a collection of signals values from RISC-V and core-specific specs.
*
* Author : BRH
*
* 12/24
*/

`timescale 1ns/1ps

package holy_core_pkg;

  typedef enum logic [3:0] { 
    IDLE,
    // AXI FULL STATES
    SENDING_WRITE_REQ,
    SENDING_WRITE_DATA,
    WAITING_WRITE_RES,
    // WHEN A WRITE REQ MISSES, IT SHOULD BE FULFILLED AFTER
    FULFILL_PENDING_WRITE,
    // STATE TO EVALUTE WHETHER A SET IS FLUSHABLE (VALID)
    // OR SHOULD BE SKIPPED
    FLUSH_NEXT, 
    SENDING_READ_REQ,
    RECEIVING_READ_DATA,
    // SIGNAL A VALID READ TO THE CPU
    READ_OK,
    // AXI LITE TX STATES FOR NO UNCACHED TXs
    LITE_SENDING_WRITE_REQ,
    LITE_SENDING_WRITE_DATA,
    LITE_WAITING_WRITE_RES,
    LITE_SENDING_READ_REQ,
    LITE_RECEIVING_READ_DATA
  } cache_state_t;

  typedef enum logic [1:0] { 
    SLAVE_IDLE,
    // WRITE REQ
    LITE_RECEIVING_WRITE_DATA,
    LITE_SENDING_WRITE_RES,
    // READ REQ
    LITE_SENDING_READ_DATA
  }axi_state_slave_t;

  // ALU STATES
  typedef enum logic [1:0] { 
    ALU_IDLE,
    ALU_BUSY,
    ALU_DONE
  } alu_state_t;

  // INSTRUCTION OP CODES
  typedef enum logic [6:0] {
    OPCODE_R_TYPE         = 7'b0110011,
    OPCODE_I_TYPE_ALU     = 7'b0010011,
    OPCODE_I_TYPE_LOAD    = 7'b0000011,
    OPCODE_S_TYPE         = 7'b0100011,
    OPCODE_B_TYPE         = 7'b1100011,
    OPCODE_U_TYPE_LUI     = 7'b0110111,
    OPCODE_U_TYPE_AUIPC   = 7'b0010111,
    OPCODE_J_TYPE         = 7'b1101111,
    OPCODE_J_TYPE_JALR    = 7'b1100111,
    OPCODE_SYSTEM         = 7'b1110011,
    OPCODE_FENCE          = 7'b0001111
  } opcode_t;

  // ALU OPs for ALU DECODER
  typedef enum logic [1:0] {
    ALU_OP_LOAD_STORE     = 2'b00,
    ALU_OP_BRANCHES       = 2'b01,
    ALU_OP_MATH           = 2'b10,
    ALU_OP_MULDIV         = 2'b11
  } alu_op_t ;

  // "MATH" F3 (R&I Types)
  typedef enum logic [2:0] {
    F3_ADD_SUB = 3'b000,
    F3_SLL     = 3'b001,
    F3_SLT     = 3'b010,
    F3_SLTU    = 3'b011,
    F3_XOR     = 3'b100,
    F3_SRL_SRA = 3'b101,
    F3_OR      = 3'b110,
    F3_AND     = 3'b111
  } funct3_t;

  // BRANCHES F3
  typedef enum logic [2:0] {
    F3_BEQ  = 3'b000,
    F3_BNE  = 3'b001,
    F3_BLT  = 3'b100,
    F3_BGE  = 3'b101,
    F3_BLTU  = 3'b110,
    F3_BGEU  = 3'b111
  } branch_funct3_t;

  // LOAD & STORES F3
  typedef enum logic [2:0] {
    F3_WORD = 3'b010,
    F3_BYTE = 3'b000,
    F3_BYTE_U = 3'b100,
    F3_HALFWORD = 3'b001,
    F3_HALFWORD_U = 3'b101
  } load_store_funct3_t;

  // F7 for shifts
  typedef enum logic [6:0] {
    F7_SLL_SRL  = 7'b0000000,
    F7_SRA  = 7'b0100000
  } shifts_f7_t;

  // F7 for R-Types
  typedef enum logic [6:0] {
    F7_ADD  = 7'b0000000,
    F7_SUB  = 7'b0100000
  } rtype_f7_t;

  // ALU control arithmetic
  typedef enum logic [4:0] {
    ALU_ADD       = 5'b00000,
    ALU_SUB       = 5'b00001,
    ALU_AND       = 5'b00010,
    ALU_OR        = 5'b00011,
    ALU_SLL       = 5'b00100,
    ALU_SLT       = 5'b00101,
    ALU_SRL       = 5'b00110,
    ALU_SLTU      = 5'b00111,
    ALU_XOR       = 5'b01000,
    ALU_SRA       = 5'b01001,
    ALU_MUL       = 5'b01010,
    ALU_MULH      = 5'b01011,
    ALU_MULHSU    = 5'b01100,
    ALU_MULHU     = 5'b01101,
    ALU_DIV       = 5'b01110,
    ALU_DIVU      = 5'b01111,
    ALU_REM       = 5'b10000,
    ALU_REMU      = 5'b10001,
    // Default "error" place holder
    ALU_ERROR     = 5'b11111
  } alu_control_t;

  // IMM sources
  typedef enum logic [2:0] {
    I_IMM_SOURCE = 3'b000,
    S_IMM_SOURCE = 3'b001,
    B_IMM_SOURCE = 3'b010,
    J_IMM_SOURCE = 3'b011,
    U_IMM_SOURCE = 3'b100,
    CSR_IMM_SOURCE = 3'b101
  } imm_source_t;

  // WRITE BACK Sources
  typedef enum logic [2:0] {
    WB_SOURCE_ALU_RESULT = 3'b000,
    WB_SOURCE_MEM_READ = 3'b001,
    WB_SOURCE_PC_PLUS_FOUR = 3'b010,
    WB_SOURCE_SECOND_ADD = 3'b011,
    WB_SOURCE_CSR_READ = 3'b100
  } wb_source_t;

  // SECOND ADDER Sources (pc offsets operations)
  typedef enum logic [1:0] {
    SECOND_ADDER_SOURCE_PC = 2'b00,
    SECOND_ADDER_SOURCE_ZERO = 2'b01,
    SECOND_ADDER_SOURCE_RD = 2'b10
  } second_add_source_t;

  // CSR WRITE BACK SOURCE
  typedef enum logic {
    CSR_WB_SOURCE_RD = 1'b0,
    CSR_WB_SOURCE_IMM = 1'b1
  } csr_wb_source_t;

  // ALU SECOND ARG SOURCE
  typedef enum logic {
    ALU_SOURCE_RD = 1'b0,
    ALU_SOURCE_IMM = 1'b1
  } alu_source_t;

  // PC SOURCES
  typedef enum logic [2:0] {
    SOURCE_PC_PLUS_4 = 3'b000,
    SOURCE_PC_SECOND_ADD = 3'b001,
    SOURCE_PC_MTVEC = 3'b010,
    SOURCE_PC_MEPC = 3'b011,
    SOURCE_PC_DPC = 3'b100
  } pc_source_t;

  // Write_back signal
  typedef struct packed {
    logic [31:0] data;
    logic valid;
  } write_back_t;

  // Aligned signal
  // When computing an address the adders
  // will assert these if the result is
  // halfword aligned or word aligned.
  typedef struct packed {
    logic word_aligned;
    logic halfword_aligned;
  } aligned_addr_signal;

  // Target addr
  // a type that concatenates computed target addresses
  // from the exec stage to conviniently bring it back to
  // the CSRs for mtval in case of an unlaugned target addr
  typedef struct packed {
    logic [31:0] alu_addr;
    logic [31:0] second_adder_addr;
  } target_addr;

  // axi mux "arbitrer" serving states
  typedef enum logic [1:0] {
      SERVING_NONE,
      SERVING_INSTR,
      SERVING_DATA
  } serving_state_t;


endpackage
