0BAB1/HOLY_CORE_COURSE/0_single_cycle_edition/src/load_store_decoder.sv

/*
* LOAD STORE DECODER
*
* BRH 10/24
*
* Sits before the data memory and allows to feed the right signals into the memory's cpu interface.
*/

`timescale 1ns/1ps

module load_store_decoder (
    input  logic [31:0] alu_result_address,
    input  logic [2:0]  f3,
    input  logic [31:0] reg_read,
    output logic [3:0]  byte_enable,
    output logic [31:0] data
);

import holy_core_pkg::*;

logic [1:0] offset;

assign offset = alu_result_address[1:0];

always_comb begin
    case (f3)
        F3_BYTE, F3_BYTE_U : begin // SB, LB, LBU
            case (offset)
                2'b00: begin
                    byte_enable = 4'b0001;
                    data = (reg_read & 32'h000000FF);
                end
                2'b01: begin 
                    byte_enable = 4'b0010;
                    data = (reg_read & 32'h000000FF) << 8;
                end
                2'b10: begin 
                    byte_enable = 4'b0100;
                    data = (reg_read & 32'h000000FF) << 16;
                end
                2'b11: begin 
                    byte_enable = 4'b1000;
                    data = (reg_read & 32'h000000FF) << 24;
                end
                default: byte_enable = 4'b0000;
            endcase
        end
        
        F3_WORD: begin // SW
            byte_enable = (offset == 2'b00) ? 4'b1111 : 4'b0000;
            data = reg_read;
        end

        F3_HALFWORD, F3_HALFWORD_U : begin // SH, LH, LHU
            case (offset)
                2'b00: begin 
                    byte_enable = 4'b0011;
                    data = (reg_read & 32'h0000FFFF);
                end
                2'b10: begin
                    byte_enable = 4'b1100;
                    data = (reg_read & 32'h0000FFFF) << 16;
                end
                default: byte_enable = 4'b0000;
            endcase
        end

        default: begin
            byte_enable = 4'b0000; // No operation for unsupported types
        end
    endcase
end

endmodule
