0BAB1/HOLY_CORE_COURSE/3_perf_edition/tb/holy_core/test_holy_core.py

# HOLY_CORE TESTBECH
#
# Based on a fixed test prgram to test
# The basics (very) quickly. This test
# Does not ensure compliance but rather
# serve as a quick reference to know if
# the design compiles and if a change
# broke the basic CPU behavior. RV
# standards compliance is ensured by
# another tesbench meant to work with
# riscof signature system.
#
# BRH 10/24

import cocotb
from cocotb.clock import Clock
from cocotb.triggers import RisingEdge, Timer
import random
from cocotbext.axi import AxiBus, AxiRam, AxiLiteBus, AxiLiteRam
import numpy as np

CPU_PERIOD = 10
DEADLOCK_MAX = 10_000

# CACHE STATES CST
IDLE                        = 0b0000
SENDING_WRITE_REQ           = 0b0001
SENDING_WRITE_DATA          = 0b0010
WAITING_WRITE_RES           = 0b0011
SENDING_READ_REQ            = 0b0100
RECEIVING_READ_DATA         = 0b0101
# LITE states, only for data cache
LITE_SENDING_WRITE_REQ      = 0b0110
LITE_SENDING_WRITE_DATA     = 0b0111
LITE_WAITING_WRITE_RES      = 0b1000
LITE_SENDING_READ_REQ       = 0b1001
LITE_RECEIVING_READ_DATA    = 0b1010

# STRESS TEST RELATED
STRESS_TEST_TIMEOUT = 200_000

async def NextInstr(dut):
    """Wait for the next instruction to be **fetched**"""
    start_pc = dut.core.pc.value
    while dut.core.pc.value == start_pc or dut.core.stall.value == 1:
        await Timer(1, units="ns")

async def wait_dcache_flush_done(dut):
    """Wait for the D$ flush to start and complete (flush duration depends on # of dirty lines)"""
    flushing = dut.core.gen_data_cache.data_cache.csr_flushing
    for _ in range(DEADLOCK_MAX):
        if flushing.value == 1:
            break
        await RisingEdge(dut.clk)
    for _ in range(DEADLOCK_MAX):
        if flushing.value == 0:
            break
        await RisingEdge(dut.clk)
    assert flushing.value == 0, "D$ flush did not complete"
    # let the last AXI write response settle in the RAM model
    for _ in range(10):
        await RisingEdge(dut.clk)

def binary_to_hex(bin_str):
    # Convert binary string to hexadecimal
    hex_str = hex(int(str(bin_str), 2))[2:]
    hex_str = hex_str.zfill(8)
    return hex_str.upper()

def hex_to_bin(hex_str):
    # Convert hex str to bin
    bin_str = bin(int(str(hex_str), 16))[2:]
    bin_str = bin_str.zfill(32)
    return bin_str.upper()

def read_cache(cache_data, line) :
    """To read cache_data, because the packed array makes it an array of bits..."""
    l = 127 - line
    return (int(str(cache_data.value[32*l:(32*l)+31]),2))

async def cpu_reset(dut):
    # Init and reset
    dut.rst_n.value = 0
    await Timer(1, units="ns")
    await RisingEdge(dut.clk)     # Wait for a clock edge after reset
    dut.rst_n.value = 1           # De-assert reset
    await RisingEdge(dut.clk)     # Wait for a clock edge after reset

async def inst_clocks(dut):
    """this instantiates the axi environement & clocks"""
    cocotb.start_soon(Clock(dut.clk, CPU_PERIOD, units="ns").start())

async def init_memory(axi_ram : AxiRam, hexfile, base_addr):
    addr_offset = 0
    with open(hexfile, "r") as file:
        for raw_instruction in file :
            addr = addr_offset + base_addr
            str_instruction = raw_instruction.split("/")[0].strip()
            instruction = int(str_instruction, 16).to_bytes(4,'little')
            axi_ram.write(addr, instruction)
            axi_ram.hexdump(addr,4)
            addr_offset += 4

@cocotb.test()
async def cpu_insrt_test(dut):

    await inst_clocks(dut)

    # ==============
    # Testbench MEMORY MAP
    # ==============
    # 0xFFFF_FFFF
    # PLIC Module registers
    # 0x9000_0000
    # ==============
    # 0x8FFF_FFFF
    # MAIN RAM (NOT used in this test, we operate in "boot rom")
    # 0x8000_0000 
    # ==============
    # 0x7FFF_FFFF
    # CLINT
    # 0x4000_0000 
    # ==============
    # 0x3FFF_FFFF
    # DEBUG MODULE'S CODE
    # 0x3000_0000
    # ==============
    # 0x2FFF_FFFF
    # PERIPHERALS (AXI RAM SLAVE)
    # 0x1000_0000
    # ==============
    # 0x0FFF_FFFF
    # BOOT ROM (used in this test)
    # 0x0000_0000
    #===============

    # most of the tb happens in boot rom as here we simply test basic Core and eventually basic SoC features
    # adn when we do, we use our own code (e.g. debug rom is actually written in test.S to see how the core
    # react simple cases)

    SIZE = 2**32
    axi_ram_slave = AxiRam(AxiBus.from_prefix(dut, "m_axi"), dut.clk, dut.rst_n, size=SIZE, reset_active_level=False)
    axi_lite_ram_slave = AxiLiteRam(AxiLiteBus.from_prefix(dut, "m_axi_lite"), dut.clk, dut.rst_n, size=SIZE, reset_active_level=False)

    await cpu_reset(dut)

    DATA_INIT_BASE_ADDR = 0x100_000
    print("init axi ram")
    await init_memory(axi_ram_slave, "./test.hex", 0x0000)
    await init_memory(axi_ram_slave, "./test_dmemory.hex", DATA_INIT_BASE_ADDR)
    print("init axi lite ram")
    await init_memory(axi_lite_ram_slave, "./test.hex", 0x0000)
    await init_memory(axi_lite_ram_slave, "./test_dmemory.hex", DATA_INIT_BASE_ADDR)


    ##################
    # SAVE BASE ADDR IN X3
    # 000011B7  DATA ADDR STORE | x3  <= 00001000
    ##################
    print("\n\nSAVING DATA BASE ADDR\n\n")

    # wait for 1st instruction to apprear : 001001b7 or # lui x3 0x100
    for _ in range(DEADLOCK_MAX):
        if dut.core.instruction.value == 0x001001b7:
            break
        await RisingEdge(dut.clk)

    # Wait a clock cycle for the instruction to execute
    await NextInstr(dut) # lui x3 0x1
    # Check the value of reg x18
    assert binary_to_hex(dut.core.regfile.registers[3].value) == "00100000"

    ##################
    # LOAD WORD TEST 
    # lw x18 0x8(x3)      | x18 <= DEADBEEF
    ##################
    print("\n\nTESTING LW\n\n")

    # The first instruction for the test in imem.hex load the data from
    # dmem @ adress 0x00000008 that happens to be 0xDEADBEEF into register x18

    # Wait for the cache to retrieve data
    while(dut.core.stall.value == 1) :
        await RisingEdge(dut.clk)

    assert binary_to_hex(dut.core.instruction.value) == "0081A903"
    await NextInstr(dut) # lw x18 0x8(x3)
    assert binary_to_hex(dut.core.regfile.registers[18].value) == "DEADBEEF"

    ##################
    # STORE WORD TEST 
    # sw x18 0xC(x3)      | 0xC <= DEADBEEF
    ##################
    print("\n\nTESTING SW\n\n")
    test_address = int(0xC / 4) 

    # we execute store and rpvoke a cache flush to
    # adapt to different caching scenarios
    
    await NextInstr(dut) # sw x18 0xC(x3)
    await NextInstr(dut) # addi x19, x0, 0x1
    await NextInstr(dut) # csrrw x0, 0x7C0, x19

    # assertions
    data_in_ram = axi_ram_slave.read(DATA_INIT_BASE_ADDR + 0XC, 4) == 0xDEADBEEF.to_bytes(4, 'little')
    data_in_lite_ram = axi_lite_ram_slave.read(DATA_INIT_BASE_ADDR + 0XC, 4) == 0xDEADBEEF.to_bytes(4, 'little')
    assert data_in_ram or data_in_lite_ram

    await Timer(1, units="ns")
    ##################
    # ADD TEST
    # lw x19 0x10(x3)     | x19 <= 00000AAA
    # add x20 x18 x19     | x20 <= DEADC999
    ##################
    print("\n\nTESTING ADD\n\n")

    # Expected result of x18 + x19
    expected_result = (0xDEADBEEF + 0x00000AAA) & 0xFFFFFFFF
        
    await NextInstr(dut)  # lw x19 0x10(x3)

    assert binary_to_hex(dut.core.regfile.registers[19].value) == "00000AAA"

    await NextInstr(dut) # add x20 x18 x19
    assert dut.core.regfile.registers[20].value == expected_result

    ##################
    # AND TEST
    # and x21 x18 x20 (result shall be 0xDEAD8889)
    ##################
    print("\n\nTESTING AND\n\n")

    # Use last expected result, as this instr uses last op result register
    expected_result = expected_result & 0xDEADBEEF
    await NextInstr(dut) # and x21 x18 x20
    assert binary_to_hex(dut.core.regfile.registers[21].value) == "DEAD8889"

    ##################
    # OR TEST
    # For this one, I decider to load some more value to change the "0xdead.... theme" ;)
    # lw x5 0x14(x3)      | x5  <= 125F552D
    # lw x6 0x18(x3)      | x6  <= 7F4FD46A
    # or x7 x5 x6         | x7  <= 7F5FD56F
    ##################
    print("\n\nTESTING OR\n\n")
    await Timer(1, units="ns")

    await NextInstr(dut) # lw x5 0x14(x3) | x5  <= 125F552D
    assert binary_to_hex(dut.core.regfile.registers[5].value) == "125F552D"

    await NextInstr(dut) # lw x6 0x18(x3) | x6  <= 7F4FD46A
    assert binary_to_hex(dut.core.regfile.registers[6].value) == "7F4FD46A"

    await NextInstr(dut) # or x7 x5 x6    | x7  <= 7F5FD56F
    assert binary_to_hex(dut.core.regfile.registers[7].value) == "7F5FD56F"

    ##################
    # BEQ TEST
    # beq x6 x7 _start    | #1 SHOULD NOT BRANCH
    # lw x22 0x8(x3)      | x22 <= DEADBEEF
    # beq x18 x22 0x10    | #2 SHOULD BRANCH (+ offset)
    # nop                 | NEVER EXECUTED
    # nop                 | NEVER EXECUTED
    # beq x0 x0 0xC       | #4 SHOULD BRANCH (avoid loop)
    # lw x22 0x0(x3)      | x22 <= AEAEAEAE
    # beq x22 x22 -0x8    | #3 SHOULD BRANCH (-offset)
    # nop                 | FINAL NOP
    ##################
    print("\n\nTESTING BEQ\n\n")
    await NextInstr(dut) # beq x6 x7 NOT TAKEN

    await NextInstr(dut) # lw x22 0x8(x3)
    assert binary_to_hex(dut.core.regfile.registers[22].value) == "DEADBEEF"

    assert dut.core.control_unit.branch.value == 1
    await NextInstr(dut) # beq x18 x22 TAKEN

    await NextInstr(dut) # lw x22 0x0(x3)
    assert binary_to_hex(dut.core.regfile.registers[22].value) == "AEAEAEAE"

    await NextInstr(dut) # beq x22 x22 -0x8 TAKEN

    await NextInstr(dut) # beq x0 x0 0xC TAKEN

    await NextInstr(dut) # nop

    ##################
    # jal x1 (to lw instruction below)
    # nop
    # nop
    # nop
    # nop
    # lw x7 0xC(x3)
    ##################
    print("\n\nTESTING JAL\n\n")

    assert dut.core.control_unit.jump.value == 1
    await NextInstr(dut) # jal x1 (to lw instruction below)
    
    await NextInstr(dut) # lw x7 0xC(x3)
    assert binary_to_hex(dut.core.regfile.registers[7].value) == "DEADBEEF"
    
    ##################
    # ADDI TEST
    # addi x26 x7 0x1AB   | x26 <= DEADC09A
    # addi x25 x6 0xF21   | x25 <= DEADBE10
    ##################
    print("\n\nTESTING ADDI\n\n")

    # Check test's init state
    assert binary_to_hex(dut.core.instruction.value) == "1AB38D13"
    assert not binary_to_hex(dut.core.regfile.registers[26].value) == "DEADC09A"

    await NextInstr(dut) # addi x26 x7 0x1AB
    assert binary_to_hex(dut.core.regfile.registers[26].value) == "DEADC09A"

    await NextInstr(dut) # NOP

    ##################
    # AUIPC TEST (PC befor is 0x64)
    # auipc x5 0x1F1FA    | x5 <= 1F1FA068      PC 0x68
    ##################
    print("\n\nTESTING AUIPC\n\n")

    # Check test's init state
    while not binary_to_hex(dut.core.instruction.value) == "1F1FA297":
        await Timer(1, units="ns")

    test_pc = (0x1F1FA << 12) + int(dut.core.pc.value)
    await NextInstr(dut) # auipc x5 0x1F1FA
    assert int(dut.core.regfile.registers[5].value) == test_pc

    ##################
    # LUI TEST
    # lui x5 0x2F2FA      | x5 <= 2F2FA000
    ##################
    print("\n\nTESTING LUI\n\n")

    # Check test's init state
    while(dut.core.stall.value == 1) :
        await RisingEdge(dut.clk)
    assert binary_to_hex(dut.core.instruction.value) == "2F2FA2B7"

    await NextInstr(dut) # lui x5 0x2F2FA 
    assert binary_to_hex(dut.core.regfile.registers[5].value) == "2F2FA000"

    ##################
    # nop
    # slti x23 x23 0x001  | x23 <= 00000001
    ##################
    print("\n\nTESTING SLTI\n\n")

    await NextInstr(dut) # nop

    await NextInstr(dut) # slti x23 x23 0x001
    assert binary_to_hex(dut.core.regfile.registers[23].value) == "00000001"

    ##################
    # nop
    # sltiu x22 x19 0x001 | x22 <= 00000000
    ##################
    print("\n\nTESTING SLTIU\n\n")

    await NextInstr(dut) # nop

    await NextInstr(dut) # sltiu x22 x19 0x001 
    assert binary_to_hex(dut.core.regfile.registers[22].value) == "00000000"

    ##################
    # nop
    # xori x19 x18 0x000
    ##################
    print("\n\nTESTING XORI\n\n")

    await NextInstr(dut) # nop

    await NextInstr(dut) # xori x19 x18 0x000 
    assert binary_to_hex(dut.core.regfile.registers[19].value) == binary_to_hex(dut.core.regfile.registers[18].value)

    ##################
    # nop
    # ori x21 x20 0x000
    ##################
    print("\n\nTESTING ORI\n\n")

    await NextInstr(dut) # nop

    await NextInstr(dut) # ori x21 x20 0x000
    assert binary_to_hex(dut.core.regfile.registers[21].value) == binary_to_hex(dut.core.regfile.registers[20].value)

    ##################
    # andi x18 x20 0x7FF 
    # nop
    # andi x20 x21 0x000
    ##################
    print("\n\nTESTING ANDI\n\n")

    # Check test's init state
    while(dut.core.stall.value == 1) :
        await RisingEdge(dut.clk)
    assert binary_to_hex(dut.core.instruction.value) == "7FFA7913"

    await NextInstr(dut) # andi x18 x20 0x7FF
    assert binary_to_hex(dut.core.regfile.registers[18].value) == "00000199"

    await NextInstr(dut) # nop

    await NextInstr(dut) # andi x20 x21 0x000 
    assert binary_to_hex(dut.core.regfile.registers[20].value) == "00000000"
    
    ##################
    # slli x19 x19 0x4 
    # NOP
    ##################
    print("\n\nTESTING SLLI\n\n")

    # Check test's init state
    while(dut.core.stall.value == 1) :
        await RisingEdge(dut.clk)
    assert binary_to_hex(dut.core.instruction.value) == "00499993"

    await NextInstr(dut) # slli x19 x19 0x4
    assert binary_to_hex(dut.core.regfile.registers[19].value) == "EADBEEF0"

    await NextInstr(dut) # NOP

    ##################
    # srli x20 x19 0x4 
    # NOP
    ##################
    print("\n\nTESTING SRLI\n\n")

    # Check test's init state
    while(dut.core.stall.value == 1) :
        await RisingEdge(dut.clk)
    assert binary_to_hex(dut.core.instruction.value) == "0049DA13"

    await NextInstr(dut) # srli x20 x19 0x4
    assert binary_to_hex(dut.core.regfile.registers[20].value) == "0EADBEEF"

    await NextInstr(dut) # NOP


    ##################
    # srai x21 x21 0x4 
    # NOP
    ##################
    print("\n\nTESTING SRAI\n\n")

    # Check test's init state
    while(dut.core.stall.value == 1) :
        await RisingEdge(dut.clk)
    assert binary_to_hex(dut.core.instruction.value) == "404ADA93"

    await NextInstr(dut) # srai x21 x21 0x4
    assert binary_to_hex(dut.core.regfile.registers[21].value) == "FDEADC99"

    await NextInstr(dut) # NOP

    ##################
    # sub x18 x21 x18 
    ##################
    print("\n\nTESTING SUB\n\n")

    # Check test's init state
    while(dut.core.stall.value == 1) :
        await RisingEdge(dut.clk)
    assert binary_to_hex(dut.core.instruction.value) == "412A8933"

    await NextInstr(dut) # sub x18 x21 x18
    assert binary_to_hex(dut.core.regfile.registers[18].value) == "FDEADB00"
    
    ##################
    # addi x7 x0 0x8
    # sll x18 x18 x7
    ##################
    print("\n\nTESTING SLL\n\n")

    # Check test's init state
    while(dut.core.stall.value == 1) :
        await RisingEdge(dut.clk)
    assert binary_to_hex(dut.core.instruction.value) == "00800393"

    await NextInstr(dut) # addi x7 x0 0x8
    assert binary_to_hex(dut.core.regfile.registers[7].value) == "00000008"

    await NextInstr(dut) # sll x18 x18 x7
    assert binary_to_hex(dut.core.regfile.registers[18].value) == "EADB0000"
    
    ##################
    # slt x17 x22 x23
    ##################
    print("\n\nTESTING SLT\n\n")

    # Check test's init state
    while(dut.core.stall.value == 1) :
        await RisingEdge(dut.clk)
    assert binary_to_hex(dut.core.instruction.value) == "017B28B3"

    await NextInstr(dut) # slt x17 x22 x23
    assert binary_to_hex(dut.core.regfile.registers[17].value) == "00000001"
    
    ##################
    # sltu x17 x22 x23 
    ##################
    print("\n\nTESTING SLTU\n\n")

    # Check test's init state
    while(dut.core.stall.value == 1) :
        await RisingEdge(dut.clk)
    assert binary_to_hex(dut.core.instruction.value) == "017B38B3"

    await NextInstr(dut) # sltu x17 x22 x23
    assert binary_to_hex(dut.core.regfile.registers[17].value) == "00000001"
    
    ##################
    # xor x17 x18 x19
    ##################
    print("\n\nTESTING XOR\n\n")

    # Check test's init state
    while(dut.core.stall.value == 1) :
        await RisingEdge(dut.clk)
    assert binary_to_hex(dut.core.instruction.value) == "013948B3"

    await NextInstr(dut) # xor x17 x18 x19
    assert binary_to_hex(dut.core.regfile.registers[17].value) == "0000EEF0"

    ##################
    # srl x8 x19 x7
    ##################
    print("\n\nTESTING SRL\n\n")

    # Check test's init state
    while(dut.core.stall.value == 1) :
        await RisingEdge(dut.clk)
    assert binary_to_hex(dut.core.instruction.value) == "0079D433"

    await NextInstr(dut) # srl x8 x19 x7
    assert binary_to_hex(dut.core.regfile.registers[8].value) == "00EADBEE"

    ##################
    # sra x8 x19 x7
    ##################
    print("\n\nTESTING SRA\n\n")

    # Check test's init state
    while(dut.core.stall.value == 1) :
        await RisingEdge(dut.clk)
    assert binary_to_hex(dut.core.instruction.value) == "4079D433"

    await NextInstr(dut) # sra x8 x19 x7 
    assert binary_to_hex(dut.core.regfile.registers[8].value) == "FFEADBEE"
    
    ##################
    # blt x17 x8 0x8      | not taken : x8 neg (sign), x17 pos (no sign)
    # blt x8 x17 0x8      | taken : x8 neg (sign), x17 pos (no sign)
    # addi x8 x0 0xC      | NEVER EXECUTED (check value)
    ##################
    print("\n\nTESTING BLT\n\n")

    # execute, branch should NOT be taken !
    await NextInstr(dut) # blt x17 x8 0x8
    while(dut.core.stall.value == 1) :
        await RisingEdge(dut.clk)
    assert binary_to_hex(dut.core.instruction.value) == "01144463"

    # execute, branch SHOULD be taken !
    await NextInstr(dut) # blt x8 x17 0x8
    while(dut.core.stall.value == 1) :
        await RisingEdge(dut.clk)
    assert not binary_to_hex(dut.core.instruction.value) == "00C00413"
    # We verify x8 value was not altered by addi instruction, because it was never meant tyo be executed (sad)
    assert binary_to_hex(dut.core.regfile.registers[8].value) == "FFEADBEE"

    ##################
    # bne x8 x8 0x8  
    # bne x8 x17 0x8 
    # addi x8 x0 0xC 
    ##################
    print("\n\nTESTING BNE\n\n")

    # execute, branch should NOT be taken !
    await NextInstr(dut) # bne x8 x8 0x8
    while(dut.core.stall.value == 1) :
        await RisingEdge(dut.clk)
    assert binary_to_hex(dut.core.instruction.value) == "01141463"

    # execute, branch SHOULD be taken !
    await NextInstr(dut) # bne x8 x17 0x8
    while(dut.core.stall.value == 1) :
        await RisingEdge(dut.clk)
    assert not binary_to_hex(dut.core.instruction.value) == "00C00413"
    # We verify x8 value was not altered by addi instruction, because it was never meant tyo be executed (sad)
    assert binary_to_hex(dut.core.regfile.registers[8].value) == "FFEADBEE"

    ##################
    # BGE TEST
    # bge_test:
    # bge x8, x17, bge_addi # not taken
    # # bug fix 12/2025
    # li t0, 0x0c6
    # bgez t0, bge_test_2 # should branch !
    # j dummy_destination # if not, flow is broken here
    # bge_test_2:
    # bge x8, x8, bltu_test # taken
    # bge_addi:
    # addi x8, x0, 12
    ##################
    print("\n\nTESTING BGE\n\n")

    # execute, branch should NOT be taken !
    await NextInstr(dut) # bge x8 x17 0x8 
    await NextInstr(dut) # li t0, 0x0c6
    assert dut.core.regfile.registers[5].value == 0xc6

    # This branch SHOULD NOT be taken !
    await NextInstr(dut) # bgez t0, dummy_destination (not taken)

    # This branch SHOULD be taken !
    await NextInstr(dut) # bge x8 x8 0x8
    assert not binary_to_hex(dut.core.instruction.value) == "00C00413"
    # We verify x8 value was not altered by addi instruction, because it was never meant tyo be executed (sad)
    assert binary_to_hex(dut.core.regfile.registers[8].value) == "FFEADBEE"

    ##################
    # bltu x8 x17 0x8    
    # bltu x17 x8 0x8    
    # addi x8 x0 0xC   
    ##################
    print("\n\nTESTING BLTU\n\n")

    # execute, branch should NOT be taken !
    await NextInstr(dut) # bltu x8 x17 0x8
    while(dut.core.stall.value == 1) :
        await RisingEdge(dut.clk)
    assert binary_to_hex(dut.core.instruction.value) == "0088E463"

    # execute, branch SHOULD be taken !
    await NextInstr(dut) # bltu x17 x8 0x8
    while(dut.core.stall.value == 1) :
        await RisingEdge(dut.clk)
    assert not binary_to_hex(dut.core.instruction.value) == "00C00413"
    # We verify x8 value was not altered by addi instruction, because it was never meant tyo be executed (sad)
    assert binary_to_hex(dut.core.regfile.registers[8].value) == "FFEADBEE"

    ##################
    # bgeu x17 x8 0x8 
    # bgeu x8 x17 0x8    
    # addi x8 x0 0xC     
    ##################
    print("\n\nTESTING BGEU\n\n")

    # execute, branch should NOT be taken !
    await NextInstr(dut) # bgeu x17 x8 0x8
    while(dut.core.stall.value == 1) :
        await RisingEdge(dut.clk)
    assert binary_to_hex(dut.core.instruction.value) == "01147463"

    # execute, branch SHOULD be taken !
    await NextInstr(dut) # bgeu x8 x17 0x8 
    while(dut.core.stall.value == 1) :
        await RisingEdge(dut.clk)
    assert not binary_to_hex(dut.core.instruction.value) == "00C00413"
    # We verify x8 value was not altered by addi instruction, because it was never meant tyo be executed (sad)
    assert binary_to_hex(dut.core.regfile.registers[8].value) == "FFEADBEE"

    ##################
    # auipc x7 0x0    
    # addi x7 x7 0x14 
    # jalr x1  -4(x7) 
    # addi x8 x0 0xC  
    # nop
    ##################
    print("\n\nTESTING JALR\n\n")

    # Check test's init state
    while not dut.core.instruction.value == 0x00000397:
        await Timer(2, units="ns")

    test_value = int(dut.core.pc.value) + 0x10 + 4
    await NextInstr(dut) # auipc x7 0x00
    await NextInstr(dut) # addi x7 x7 0x10 
    assert int(dut.core.regfile.registers[7].value) == test_value

    while dut.core.instruction.value != 0xFFC380E7:
        await Timer(2, units="ns")

    test_pc = int(dut.core.pc.value)
    await NextInstr(dut) # jalr x1  -4(x7)
    await NextInstr(dut) # nop

    assert dut.core.regfile.registers[1].value == test_pc +4

    #################
    # sb x8 0x6(x3)
    # addi x7, x0, 0x1
    # csrrw x0, 0x7C0, x7
    ##################
    print("\n\nTESTING SB\n\n")

    await NextInstr(dut) # sb x8 0x6(x3)
    await NextInstr(dut) # addi x7, x0, 0x1
    await NextInstr(dut) # csrrw x0, 0x7C0, x7

    # we wait for d_cache to be ready by awayating a dummy lw
    await NextInstr(dut) # lw x0, 0(x3)

    # depending on caching params, we might find our data in either ram
    in_lite = int.from_bytes(axi_lite_ram_slave.read(DATA_INIT_BASE_ADDR + 0X4, 4), byteorder="little") == 0x00EE_0000
    in_full = int.from_bytes(axi_ram_slave.read(DATA_INIT_BASE_ADDR + 0X4, 4), byteorder="little") == 0x00EE_0000
    assert in_lite or in_full

    #################
    # nop
    # nop
    # sh x8 6(x3)
    # addi x7, x0, 0x1
    # csrrw x0, 0x7C0, x7
    # NOTE : misaligned stores throws an excption
    # and these tests are covered by riscof and not
    # here anymore, thus the nop placeholders
    ##################
    print("\n\nTESTING SH\n\n")

    # Check test's init state
    while(dut.core.stall.value == 1) :
        await RisingEdge(dut.clk)
    assert binary_to_hex(dut.core.instruction.value) == "00000013"

    
    await NextInstr(dut) # nop
    await NextInstr(dut) # nop

    await NextInstr(dut) # sh x8 6(x3) 
    await NextInstr(dut) # addi x7, x0, 0x1
    await NextInstr(dut) # csrrw x0, 0x7C0, x7

    # we wait for d_cache to be ready by awayating a dummy lw
    await NextInstr(dut) # lw x0, 0(x3)

    # axi_lite_ram_slave.hexdump(0x1004,4)
    # print(hex(int.from_bytes(axi_lite_ram_slave.read(0x1004, 4), byteorder="little")))
    # print(hex(int.from_bytes(axi_lite_ram_slave.read(0x1004, 4), byteorder="little")))

    # depending on caching params, we might find our data in either ram
    in_lite = int.from_bytes(axi_lite_ram_slave.read(DATA_INIT_BASE_ADDR + 0X4, 4), byteorder="little") == 0xDBEE0000
    in_full = int.from_bytes(axi_ram_slave.read(DATA_INIT_BASE_ADDR + 0X4, 4), byteorder="little") == 0xDBEE0000
    assert in_lite or in_full

    #################
    # PARTIAL LOADS
    # addi x7 x3 0x10
    # nop
    # lb x18 -1(x7)  
    # lbu x19 -3(x7) 
    # nop 
    # lh x20 -6(x7)  
    # nop 
    # lhu x21 -6(x7) 
    # NOTE : misaligned loads throws an excption
    # and these tests are covered by riscof and not
    # here anymore, thus the nop placeholder
    ##################
    print("\n\nTESTING LB\n\n")

    # Check test's init state
    while(dut.core.stall.value == 1) :
        await RisingEdge(dut.clk)
    assert binary_to_hex(dut.core.instruction.value) == "01018393"

    await NextInstr(dut) # addi x7 x3 0x10 
    # assert binary_to_hex(dut.core.regfile.registers[7].value) == "00001010"
    assert binary_to_hex(dut.core.regfile.registers[18].value) == "EADB0000"

    await NextInstr(dut) # nop

    await NextInstr(dut) # lb x18 -1(x7) 
    assert binary_to_hex(dut.core.regfile.registers[18].value) == "FFFFFFDE"

    await NextInstr(dut) # lbu x19 -3(x7)
    assert binary_to_hex(dut.core.regfile.registers[19].value) == "000000BE"

    await NextInstr(dut) # nop

    await NextInstr(dut) # lh x20 -6(x7)
    assert binary_to_hex(dut.core.regfile.registers[20].value) == "FFFFDEAD"

    await NextInstr(dut) # nop

    await NextInstr(dut) # lhu x21 -6(x7)
    assert binary_to_hex(dut.core.regfile.registers[21].value) == "0000DEAD"

    ##################
    # MUL TEST START
    # li x5, 0x12345678
    # li x6, 0x1212ABCD
    # mul x4, x5, x6
    ##################
    print("\n\nTESTING MUL\n\n")

    await NextInstr(dut); await NextInstr(dut) # li x5, 0x12345678
    await NextInstr(dut); await NextInstr(dut) # li x6, 0x1212ABCD
    await NextInstr(dut) # mul x4, x5, x6

    assert dut.core.regfile.registers[4].value == (0x12345678 * 0x1212ABCD) & 0xFFFFFFFF

    ##################
    # MULH TEST START
    # li x5, 0x00000005
    # li x6, 0xFFFFFFFF
    # mul x4, x5, x6
    ##################
    print("\n\nTESTING MULH\n\n")

    await NextInstr(dut) # li x5, 0x00000005
    await NextInstr(dut) # li x6, 0xFFFFFFFF
    await NextInstr(dut) # mulh x4, x5, x6
    # result of this simple mul signed is -5, so upper bits carry the sign (all 1s)
    assert dut.core.regfile.registers[4].value == 0xFFFFFFFF

    ##################
    # MULHSU TEST START
    # li x5, 0xFFFFFFFF
    # li x6, 0xF123F123
    # mulsu x4, x5, x6
    ##################
    print("\n\nTESTING MULHSU\n\n")

    await NextInstr(dut) # li x5, 0xFFFFFFFF
    await NextInstr(dut) # li x6, 0xF123F123
    await NextInstr(dut) # mulhsu x4, x5, x6

    # x5 interpreted as signed and x6 as unsigned
    assert dut.core.regfile.registers[4].value == ((-1 * 0xF123F123) & 0xFFFFFFFF << 32) >> 32

    ##################
    # MULHU TEST START
    # mulhu x4, x5, x6
    ##################
    print("\n\nTESTING MULHU\n\n")

    await NextInstr(dut); await NextInstr(dut) # mulhu x4, x5, x6

    # this time, x5 AND x6 are interpreted as unsigned, so no signext should happen and whe shoud have a raw result
    assert dut.core.regfile.registers[4].value == ((0xFFFFFFFF * 0xF123F123) & 0xFFFFFFFF << 32) >> 32
    
    ##################
    # DIV TEST START
    # li x5, 0xFFFFFFFF
    # li x6, 0x00000003
    # div x4, x5, x6
    ##################
    print("\n\nTESTING DIV\n\n")

    await NextInstr(dut) # li x5, 0xFFFFFFFF
    await NextInstr(dut) # li x6, 0x00000003
    await NextInstr(dut) # div x4, x5, x6

    dividend = 0xF0000000
    dividend_signed = dividend - 0x100000000 if dividend >= 0x80000000 else dividend
    expected = int(dividend_signed / 3) & 0xFFFFFFFF

    assert dut.core.regfile.registers[4].value == expected
    assert expected == 0xFAAAAAAB

    ##################
    # DIVU TEST START
    # divu x4, x5, x6
    ##################
    print("\n\nTESTING DIVU\n\n")

    await NextInstr(dut); await NextInstr(dut); await NextInstr(dut) # divu x4, x5, x6
    assert dut.core.regfile.registers[4].value == 0xF0000000 // 3

    ##################
    # REM TEST START
    # li x5, 0xF0000005
    # li x6, 0x00000003
    # rem x4, x5, x6
    ##################
    print("\n\nTESTING REM\n\n")

    await NextInstr(dut); await NextInstr(dut) # li x5, 0xF0000005
    await NextInstr(dut) # li x5, 0xF0000005
    await NextInstr(dut) # rem x4, x5, x6
    
    assert int(dut.core.regfile.registers[4].value) - (1 << 32) == -2

    ##################
    # REMU TEST START
    # remu x4, x5, x6
    ##################
    print("\n\nTESTING REMU\n\n")

    await NextInstr(dut) # remu x4, x5, x6

    assert dut.core.regfile.registers[4].value == 2

    #################
    # SOFTWARE INTERRUPT TEST
    #################

    print("\n\nTESTING SOFT IRT\n\n")
    # Interrupts tests are pretty straight forward. The behavior
    # should be an interrupt assertion, followed by an mret
    # at some point, after which interrupt is vleared by the handler.
    # Meeting these conditions, along some other additional checks
    # Ensures basic bahavior is okay.

    # We set the MIE csr, activate all interrupts (note: now we do it using actual instrs)
    # dut.core.holy_csr_file.mie.value = 1 << 3 | 1 << 7 | 1 << 11
    # dut.core.holy_csr_file.mstatus.value = 1 << 3

    # Wait until we are about to write 1 to software interrupt
    while not binary_to_hex(dut.core.instruction.value) == "00522023":
        await RisingEdge(dut.clk)
    
    await NextInstr(dut) # sw x5 0(x4)

    # we wait for d_cache to be ready by awayating a dummy lw
    # lw x0, 0(x3)
    
    # a software interrupt should be raised
    assert dut.clint.soft_irq.value == 1
    assert dut.core.trap.value == 1 or dut.core.control_unit.trap_pending.value == 1

    # wait until we are about to mret
    while not binary_to_hex(dut.core.instruction.value) == "30200073":
        await RisingEdge(dut.clk) # mret

    # check that x3° was signed with the right mcause by handler
    assert binary_to_hex(dut.core.regfile.registers[30].value) == "80000003"
    
    #################
    # TIMER INTERRUPT TEST
    #################

    print("\n\nTESTING TIMER IRT\n\n")
    # Wait until we have a timer irq
    while dut.core.timer_itr.value != 1:
        await RisingEdge(dut.clk)

    # wait until we are about to mret
    while not binary_to_hex(dut.core.instruction.value) == "30200073":
        await RisingEdge(dut.clk) # mret

    # timer interrupt is cleared
    assert dut.core.timer_itr.value == 0

    # mcause saved in x30 is the right one
    assert binary_to_hex(dut.core.regfile.registers[30].value) == "80000007"

    #################
    # EXTERNAL INTERRUPT TEST
    #################

    print("\n\nTESTING EXT IRT\n\n")
    # In this scerio, we will emulate a simple peripheral
    # that latches an interrupt until the CPU enters its handler
    # and we'll de-assert the said interrupt req when the CPU executes
    # a specific signal : a simple NOP in the trap handler.

    # Wait for previous mret to finish (instr cache may be pulling data)
    while binary_to_hex(dut.core.instruction.value) == "30200073":
        await RisingEdge(dut.clk)

    # wait until ext irq waiting loop
    while not binary_to_hex(dut.core.instruction.value) == "0000006F":
        await RisingEdge(dut.clk)

    # Introduce an external itr request in the PLIC
    dut.irq_in.value = int(dut.irq_in.value) | 1

    # wait until plic asserts that interrupt
    while not dut.core.ext_itr.value == 1:
        await RisingEdge(dut.clk)

    # wait until we are about to mret
    while not binary_to_hex(dut.core.instruction.value) == "30200073":
        # NOP is our placeholder to deassert the interrupt request
        if binary_to_hex(dut.core.instruction.value) == "00000013":
            dut.irq_in.value =  0
        await RisingEdge(dut.clk)
    
    # check that the interrupt is cleared
    await Timer(1, unit="ns")
    #assert dut.core.ext_itr.value == 0
    # mcause saved in x30 is the right one
    assert binary_to_hex(dut.core.regfile.registers[30].value) == "8000000B"

    #################
    # ECALL EXCEPTION TEST
    #################

    print("\n\nTESTING ECALL IRT\n\n")
    # wait for ecall to be fetched
    while not binary_to_hex(dut.core.instruction.value) == "00000073":
        await RisingEdge(dut.clk)

    assert dut.core.exception.value == 1
    assert dut.core.trap.value == 1
    
    # wait until we are about to mret (mret fetched)
    while not binary_to_hex(dut.core.instruction.value) == "30200073":
        await RisingEdge(dut.clk)

    assert dut.core.exception.value == 0
    assert dut.core.trap.value == 0

    #assert binary_to_hex(dut.core.regfile.registers[30].value) == "0000000B"

    #################
    # DEBUG REQUEST TEST
    #################

    print("\n\nTESTING DEBUG REQ\n\n")
    assert dut.core.holy_csr_file.dscratch0.value == 0

    # we use this this NOP (00000013) to mark the beginning of the debug test
    while not binary_to_hex(dut.core.instruction.value) == "00000013":
        await RisingEdge(dut.clk)

    # send a debug request
    print("\n\n==========\n\nTESTBENCH IS SENDING A DEBUG REQ TO DUT...\n\n=========\n\n")

    # in the test code, we pass the addres at which debug code live (assigned at link time) through register x5 (t0)
    dut.core.debug_halt_addr.value = dut.core.regfile.registers[5].value
    halt_value = dut.core.regfile.registers[5].value
    dut.core.debug_exception_addr.value = dut.core.regfile.registers[6].value
    await RisingEdge(dut.clk)
    await RisingEdge(dut.clk)
    dut.core.debug_req.value = 1
    await Timer(1, units="ns")

    while dut.core.stall.value == 1:
        await RisingEdge(dut.clk)

    # wait to switch to debug mode
    print("\n\n==========\n\nTESTBENCH IS WAITING FOR CORE TO ENTER DEBUG MODE...\n\n=========\n\n")
    while not dut.core.holy_csr_file.debug_mode.value == 1:
        # save the last known pc to later check is dpc saves it well
        pc_save = int(dut.core.pc.value)
        await RisingEdge(dut.clk)

    print("\n\n==========\n\nCORE ENTERED DEBUG MODE !\n\n=========\n\n")
    dut.core.debug_req.value = 0
    await Timer(1, units="ns")

    # wait for ebreak
    print("\n\n==========\n\nWATING FOR EBREAK...\n\n=========\n\n")
    while not binary_to_hex(dut.core.instruction.value) == "00100073":
        assert dut.core.holy_csr_file.debug_mode.value == 1
        await RisingEdge(dut.clk)
    
    # RV debug specs : "When ebreak is executed (indicating the end
    # of the Program Buffer code) the hart returns to its park loop.
    # If an exception is encountered, the hart jumps to a debug
    # exception address within the Debug Module."
    print("\n\n==========\n\nCORE RETURNING TO PARK LOOP..\n\n=========\n\n")
    await NextInstr(dut)
    assert int(dut.core.pc.value) == halt_value

    # wait for dret
    print("\n\n==========\n\nWAITING FOR DEBUG REUTRN...\n\n=========\n\n")
    while not binary_to_hex(dut.core.instruction.value) == "7B200073":
        assert dut.core.holy_csr_file.debug_mode.value == 1
        await RisingEdge(dut.clk)

    assert dut.core.holy_csr_file.dscratch0.value == 1

    await RisingEdge(dut.clk)
    assert int(dut.core.holy_csr_file.dpc.value) == pc_save
    assert dut.core.holy_csr_file.debug_mode.value == 0
    dut.core.debug_req.value = 0

    #################
    # SINGLE STEP DEBUG REQUEST TEST
    #################

    print("\n\nTESTING SINGLE STEPPING\n\n")
    assert dut.core.holy_csr_file.dscratch0.value == 1

    # ======
    # The core is now back in wait for debug loop
    # This test is broken down in 2 parts :
    # ====
    # 1. We make the core enter debug mode, because dscratch is 1
    #    the program will send us to a single step test in which we'll
    #    set "step" flag in dscr. We have to make sure that only 1 instr
    #    is executed before going back.
    # ====
    # 2. After the step, HOLY CORE goes back to debug mode and to single
    #    step step. The program sees that step is set, so it clears it and
    #    sets dsratch to 2, signaling a sucess of this test. when then dret
    #    a final time
    # ======


    # ====
    # 1
    # ====

    dut.core.debug_req.value = 1
    await NextInstr(dut)
    dut.core.debug_req.value = 0
    
    while dut.core.stall.value == 1:
        await RisingEdge(dut.clk)

    assert int(dut.core.holy_csr_file.dcsr.value) >> 2 & 0b1 != 1

    while int(dut.core.holy_csr_file.dcsr.value) >> 2 & 0b1 != 1:
        # we wait for step flag in dcsr to be set
        await RisingEdge(dut.clk)
    

    # we await the 1st dret from the set_step section
    # this dret jumps to dpc which has been set to a cachable range
    # altering instruction (set_i_cache) to monitor behavior
    while not dut.core.instruction.value == 0x7b200073:
        await Timer(1, units="ns")
        
    await NextInstr(dut) # execute dret from the "set step" section

    # check if we exited debug mode
    assert dut.core.holy_csr_file.debug_mode.value == 0

    await NextInstr(dut) # execute EXACTLY 1 instruction

    # we should be back to debug mode
    assert dut.core.holy_csr_file.debug_mode.value == 1

    # ====
    # 2
    # ====

    # back to debug mode after the single step
    # the program shall clear the step flag

    while int(dut.core.holy_csr_file.dcsr.value) >> 2 & 0b1 != 0:
        # we wait for step to be cleared
        await RisingEdge(dut.clk)

    # then, the dscratch0 is set to 0x2 to signal 
    # success of the procedure

    while dut.core.holy_csr_file.dscratch0.value != 2:
        # we wait for step to be cleared
        await RisingEdge(dut.clk)

    #################
    # CACHE STRESS TEST
    #################

    # ====
    # 1 : simple sequential writes
    # ====
    print("\n\n" + "=" * 60)
    print("CACHE STRESS TEST PHASE 1")
    print("=" * 60 + "\n")

    for _ in range(10):
        await RisingEdge(dut.clk)

    
    # Wait for stress test end (use flush cache order)
    while not dut.core.instruction.value == 0x7c00d073:
        await RisingEdge(dut.clk)
    
    await wait_dcache_flush_done(dut)

    # Read checksums from 0x1200
    write_checksum = int.from_bytes(axi_ram_slave.read(0x1200, 4), byteorder="little")
    read_checksum = int.from_bytes(axi_ram_slave.read(0x1204, 4), byteorder="little")

    # Compute expected checksum: XOR of addresses 0x1000, 0x1004, ..., 0x103C
    expected = 0
    for addr in range(0x1000, 0x1040, 4):
        pattern = 0xA5A5A500 | addr
        expected = (expected + pattern) & 0xFFFFFFFF  # addition, not XOR
    
    print(f"Write checksum: 0x{write_checksum:08X}")
    print(f"Read checksum:  0x{read_checksum:08X}")
    print(f"Expected:       0x{expected:08X}")

    assert write_checksum == expected, f"Write checksum mismatch!"
    assert read_checksum == expected, f"Read checksum mismatch!"
    assert write_checksum == read_checksum, f"Write != Read checksum!"

    print("\n✓ Phase 1 PASSED: Sequential writes verified")

    # ====
    # 2 : R/W intervaling
    # ====
    print("\n\n" + "=" * 60)
    print("CACHE STRESS TEST PHASE 2")
    print("=" * 60 + "\n")

    # Wait for stress test end (use flush cache order)
    while not dut.core.instruction.value == 0x7c00d073:
        await RisingEdge(dut.clk)
    
    await wait_dcache_flush_done(dut)

    # Read checksums from 0x1200
    interleave_checksum = int.from_bytes(axi_ram_slave.read(0x1200, 4), byteorder="little")
    verify_checksum = int.from_bytes(axi_ram_slave.read(0x1204, 4), byteorder="little")

    # Expected: sum of 1+2+3+...+16 = 136
    expected = sum(range(1, 17))

    print(f"Interleave checksum: 0x{interleave_checksum:08X}")
    print(f"Verify checksum:     0x{verify_checksum:08X}")
    print(f"Expected:            0x{expected:08X}")

    assert interleave_checksum == expected, "Interleave checksum mismatch!"
    assert verify_checksum == expected, "Verify checksum mismatch!"

    print("\n✓ Phase 2 PASSED: Read-Write interleaving verified")

    # ====
    # 3 :  jumps and larger R/W
    # ====
    print("\n\n" + "=" * 60)
    print("CACHE STRESS TEST PHASE 3")
    print("=" * 60 + "\n")

    # Wait for stress test end (use flush cache order)
    while not dut.core.instruction.value == 0x7c00d073:
        await RisingEdge(dut.clk)
    
    await wait_dcache_flush_done(dut)

    # Read checksums from 0x1800
    write_checksum = int.from_bytes(axi_ram_slave.read(0x1800, 4), byteorder="little")
    verify_checksum = int.from_bytes(axi_ram_slave.read(0x1804, 4), byteorder="little")

    # Expected: sum of 1+2+3+...+256 = 32896
    expected = sum(range(1, 257))

    print(f"Write checksum:  0x{write_checksum:08X}")
    print(f"Verify checksum: 0x{verify_checksum:08X}")
    print(f"Expected:        0x{expected:08X}")

    assert write_checksum == expected, f"Write checksum mismatch! Got {write_checksum}, expected {expected}"
    assert verify_checksum == expected, f"Verify checksum mismatch! Got {verify_checksum}, expected {expected}"

    print("\n✓ Phase 3 PASSED: Jumps + large memory verified")
