0BAB1/HOLY_CORE_COURSE/3_perf_edition/tb/holy_data_cache/test_holy_data_cache.py

# CACHE TESTBENCH - Random Read Stress Test
#
# BRH 11/25
#
# Functional stress testing based tb with handshake protocol

import cocotb
from cocotb.clock import Clock
from cocotb.triggers import RisingEdge, ClockCycles, Timer
import random
from cocotbext.axi import AxiBus, AxiRam, AxiLiteBus, AxiLiteRam

CPU_PERIOD = 10
MEMORY_SIZE = 2**20
NUM_READS = 1000
NUM_WRITES = 1000
NUM_R_W = 250
# close test = nuber of near addr R/W tests
CLOSE_TESTS = 40

def generate_random_bytes(length):
    return bytes([random.randint(0, 255) for _ in range(length)])

def bytes_to_int(b):
    """Convert 4 bytes (little endian) to integer"""
    return int.from_bytes(b, byteorder='little')

def int_to_bytes(val):
    """Convert integer to 4 bytes (little endian)"""
    return val.to_bytes(4, byteorder='little')

async def reset(dut):
    """Reset the DUT"""
    await RisingEdge(dut.clk)
    dut.rst_n.value = 0
    dut.cpu_req_valid.value = 0
    dut.cpu_req_write.value = 0
    dut.cpu_address.value = 0
    dut.cpu_write_data.value = 0
    dut.cpu_byte_enable.value = 0
    dut.cpu_read_ack.value = 0
    
    await ClockCycles(dut.clk, 5)
    dut.rst_n.value = 1
    await RisingEdge(dut.clk)

async def wait_for_ready(dut, timeout=5000):
    """Wait for cache to become ready"""
    count = 0
    while dut.cpu_req_ready.value == 0:
        await RisingEdge(dut.clk)
        count += 1
        if count > timeout:
            raise Exception(f"Cache ready timeout after {timeout} cycles")

async def cpu_read(dut, address):
    """Perform a CPU read operation with handshake"""
    dut.cpu_address.value = address
    dut.cpu_req_valid.value = 1
    dut.cpu_req_write.value = 0
    dut.cpu_byte_enable.value = 0xF
    dut.cpu_read_ack.value = 1
    
    await RisingEdge(dut.clk)
    while dut.cpu_req_ready.value == 0:
        await RisingEdge(dut.clk)
    
    dut.cpu_req_valid.value = 0
    
    while dut.cpu_read_valid.value == 0:
        await RisingEdge(dut.clk)
    
    result = int(dut.cpu_read_data.value)
    await RisingEdge(dut.clk)
    
    return result

async def cpu_write(dut, address, data, byte_enable=0xF):
    """Perform a CPU write operation with handshake"""
    dut.cpu_address.value = address
    dut.cpu_write_data.value = data
    dut.cpu_req_valid.value = 1
    dut.cpu_req_write.value = 1
    dut.cpu_byte_enable.value = byte_enable
    
    await RisingEdge(dut.clk)
    while dut.cpu_req_ready.value == 0:
        await RisingEdge(dut.clk)
    
    dut.cpu_req_valid.value = 0
    dut.cpu_req_write.value = 0
    
    await RisingEdge(dut.clk)

async def flush_cache(dut):
    """Flush the cache and wait for completion"""
    dut.cache_system.csr_flush_order.value = 1
    await RisingEdge(dut.clk)
    await wait_for_ready(dut, timeout=10000)
    dut.cache_system.csr_flush_order.value = 0
    await RisingEdge(dut.clk)
    await RisingEdge(dut.clk)

@cocotb.test()
async def test_random_reads(dut):
    """Random read stress test with golden reference"""
    dut._log.info("=" * 60)
    dut._log.info("TEST: Random Read Stress Test")
    dut._log.info(f"Will perform {NUM_READS} random reads")
    dut._log.info("=" * 60)
    
    # ==================================
    # CLOCKS & RAM DECLARATION
    # ==================================
    cocotb.start_soon(Clock(dut.clk, CPU_PERIOD, units="ns").start())
    
    axi_ram = AxiRam(
        AxiBus.from_prefix(dut, "axi"), 
        dut.clk, 
        dut.rst_n, 
        size=MEMORY_SIZE, 
        reset_active_level=False
    )
    
    await RisingEdge(dut.clk)
    await reset(dut)
    
    # ==================================
    # MEMORY INIT WITH RANDOM VALUES
    # ==================================
    dut._log.info("Initializing memory with random data...")
    
    mem_golden_ref = []
    
    # Fill memory with random data (word by word)
    for address in range(0, MEMORY_SIZE, 4):
        word_bytes = generate_random_bytes(4)
        axi_ram.write(address, word_bytes)
        mem_golden_ref.append(bytes_to_int(word_bytes))
    
    dut._log.info(f"Memory initialized: {len(mem_golden_ref)} words")
    
    # Verify memory initialization
    for address in range(0, MEMORY_SIZE, 4):
        word_index = int(address / 4)
        mem_data = axi_ram.read(address, 4)
        assert bytes_to_int(mem_data) == mem_golden_ref[word_index], \
            f"Memory init verification failed at 0x{address:08X}"
    
    dut._log.info("Memory initialization verified ✓")
    
    # ==================================
    # RANDOM READ STRESS TEST
    # ==================================
    dut._log.info(f"\nStarting {NUM_READS} random reads...")
    
    errors = 0
    
    for i in range(NUM_READS):
        # Generate random word-aligned address
        word_index = random.randint(0, len(mem_golden_ref) - 1)
        address = word_index * 4
        
        # Expected data from golden reference
        expected_data = mem_golden_ref[word_index]
        
        # Perform read
        read_data = await cpu_read(dut, address)
        # Compare
        if read_data != expected_data:
            dut._log.error(f"[{i}] MISMATCH at 0x{address:08X}: " +
                          f"expected 0x{expected_data:08X}, got 0x{read_data:08X}")
            errors += 1
            assert read_data == expected_data
        else:
            # Log progress every 1000 reads
            if (i + 1) % 1000 == 0:
                dut._log.info(f"Progress: {i + 1}/{NUM_READS} reads completed ✓")
    
    # ==================================
    # FINAL REPORT
    # ==================================
    dut._log.info("=" * 60)
    dut._log.info(f"READ TEST COMPLETE")
    dut._log.info(f"Total reads: {NUM_READS}, Errors: {errors}")
    dut._log.info("=" * 60)
    
    # Assert test passed
    assert errors == 0, f"Read test failed with {errors} errors"
    dut._log.info("✓ READ TEST PASSED")


@cocotb.test()
async def test_random_writes(dut):
    """Random write stress test with verification"""
    dut._log.info("=" * 60)
    dut._log.info("TEST: Random Write Stress Test")
    dut._log.info(f"Will perform {NUM_WRITES} random writes")
    dut._log.info("=" * 60)
    
    # ==================================
    # CLOCKS & RAM DECLARATION
    # ==================================
    cocotb.start_soon(Clock(dut.clk, CPU_PERIOD, units="ns").start())
    
    axi_ram = AxiRam(
        AxiBus.from_prefix(dut, "axi"), 
        dut.clk, 
        dut.rst_n, 
        size=MEMORY_SIZE, 
        reset_active_level=False
    )
    
    await RisingEdge(dut.clk)
    await reset(dut)
    
    # ==================================
    # MEMORY INIT WITH RANDOM VALUES
    # ==================================
    dut._log.info("Initializing memory with random data...")
    
    mem_golden_ref = []
    
    # Fill memory with random data (word by word)
    for address in range(0, MEMORY_SIZE, 4):
        word_bytes = generate_random_bytes(4)
        axi_ram.write(address, word_bytes)
        mem_golden_ref.append(bytes_to_int(word_bytes))
    
    dut._log.info(f"Memory initialized: {len(mem_golden_ref)} words")
    
    # ==================================
    # RANDOM WRITE STRESS TEST
    # ==================================
    dut._log.info(f"Starting {NUM_WRITES} random writes...")
    
    for i in range(NUM_WRITES):
        # Generate random word-aligned address
        word_index = random.randint(0, len(mem_golden_ref) - 1)
        address = word_index * 4
        
        # Generate random data to write
        write_data = random.randint(0, 0xFFFFFFFF)
        
        # Perform write
        await cpu_write(dut, address, write_data)
        
        # Update golden reference
        mem_golden_ref[word_index] = write_data
        
        # Log progress every 1000 writes
        if (i + 1) % 1000 == 0:
            dut._log.info(f"Progress: {i + 1}/{NUM_WRITES} writes completed ✓")
    
    dut._log.info(f"Write test completed: {NUM_WRITES} writes performed")
    
    # ==================================
    # FLUSH CACHE
    # ==================================
    dut._log.info("=" * 60)
    dut._log.info("Flushing cache to write back all dirty lines...")
    dut._log.info("=" * 60)
    
    # Set flush order high
    dut.cache_system.csr_flush_order.value = 1
    await RisingEdge(dut.clk)
    
    # Wait for flush to complete (cache should become ready again)
    await wait_for_ready(dut, timeout=5000)
    
    # Clear flush order
    dut.cache_system.csr_flush_order.value = 0
    await RisingEdge(dut.clk)
    await RisingEdge(dut.clk)
    assert dut.cpu_req_ready.value == 1
    
    dut._log.info("Cache flush completed ✓")

    # ==================================
    # VERIFY MEMORY CONSISTENCY
    # ==================================
    dut._log.info("=" * 60)
    dut._log.info("Verifying golden reference vs AXI RAM...")
    dut._log.info("=" * 60)
    
    memory_errors = 0
    
    for address in range(0, MEMORY_SIZE, 4):
        word_index = int(address / 4)
        expected_data = mem_golden_ref[word_index]
        
        # Read from AXI RAM
        mem_data = axi_ram.read(address, 4)
        actual_data = bytes_to_int(mem_data)
        
        if actual_data != expected_data:
            dut._log.error(f"MEMORY MISMATCH at 0x{address:08X}: " +
                          f"expected 0x{expected_data:08X}, got 0x{actual_data:08X}")
            memory_errors += 1

    # ==================================
    # FINAL REPORT
    # ==================================
    dut._log.info("=" * 60)
    dut._log.info(f"WRITE TEST COMPLETE")
    dut._log.info(f"Total writes: {NUM_WRITES}")
    dut._log.info(f"Memory verification: {memory_errors} mismatches")
    dut._log.info("=" * 60)
    
    # Assert test passed
    assert memory_errors == 0, f"Memory verification failed with {memory_errors} mismatches"
    dut._log.info("✓ WRITE TEST PASSED")

@cocotb.test()
async def test_random_read_write_mixed(dut):
    """Random read/write mixed stress test with locality"""
    dut._log.info("=" * 60)
    dut._log.info("TEST: Random Read/Write Mixed Stress Test")
    dut._log.info(f"Will perform {NUM_R_W} test blocks with locality")
    dut._log.info("=" * 60)
    
    # ==================================
    # CLOCKS & RAM DECLARATION
    # ==================================
    cocotb.start_soon(Clock(dut.clk, CPU_PERIOD, units="ns").start())
    
    axi_ram = AxiRam(
        AxiBus.from_prefix(dut, "axi"), 
        dut.clk, 
        dut.rst_n, 
        size=MEMORY_SIZE, 
        reset_active_level=False
    )
    
    await RisingEdge(dut.clk)
    await reset(dut)
    
    # ==================================
    # MEMORY INIT WITH RANDOM VALUES
    # ==================================
    dut._log.info("Initializing memory with random data...")
    
    mem_golden_ref = []
    
    # Fill memory with random data (word by word)
    for address in range(0, MEMORY_SIZE, 4):
        word_bytes = generate_random_bytes(4)
        axi_ram.write(address, word_bytes)
        mem_golden_ref.append(bytes_to_int(word_bytes))
    
    dut._log.info(f"Memory initialized: {len(mem_golden_ref)} words")
    
    # ==================================
    # RANDOM R/W STRESS TEST
    # ==================================
    # This test reads and writes similar blocks of memory.
    # For each test, it performs multiple random r/w operations
    # that are close in address space to exercise cache effectively.
    dut._log.info(f"Starting {NUM_R_W} random R/W test blocks...")
    
    for i in range(NUM_R_W):
        # Generate random word-aligned base address
        word_index = random.randint(0, len(mem_golden_ref) - 5)
        glob_address = word_index * 4

        for _ in range(CLOSE_TESTS):
            # Generate a slightly offset address for this nested test
            # Stay within same cache line or nearby lines
            address = glob_address + (random.randint(0, 4) * 4)
            op_type = random.choice(["r", "w"])
            
            if op_type == "r":
                expected_data = mem_golden_ref[address >> 2]
                read_data = await cpu_read(dut, address)
                assert expected_data == read_data, \
                    f"Read mismatch at 0x{address:08X}: expected 0x{expected_data:08X}, got 0x{read_data:08X}"
            else:
                # Write random data
                write_data = random.randint(0, 0xFFFFFFFF)
                await cpu_write(dut, address, write_data)
                
                # Update golden reference
                mem_golden_ref[address >> 2] = write_data
        
        # Log progress every 10 test blocks
        if (i + 1) % 10 == 0:
            dut._log.info(f"Progress: {i + 1}/{NUM_R_W} test blocks completed ✓")
    
    dut._log.info(f"R/W stress test completed: {NUM_R_W} test blocks performed")

    # ==================================
    # FLUSH CACHE
    # ==================================
    dut._log.info("=" * 60)
    dut._log.info("Flushing cache to write back all dirty lines...")
    dut._log.info("=" * 60)
    
    # Set flush order high
    dut.cache_system.csr_flush_order.value = 1
    await RisingEdge(dut.clk)
    
    # Wait for flush to complete
    await wait_for_ready(dut, timeout=5000)
    
    # Clear flush order
    dut.cache_system.csr_flush_order.value = 0
    await RisingEdge(dut.clk)
    
    dut._log.info("Cache flush completed ✓")
    
    # ==================================
    # VERIFY MEMORY CONSISTENCY
    # ==================================
    dut._log.info("=" * 60)
    dut._log.info("Verifying golden reference vs AXI RAM...")
    dut._log.info("=" * 60)
    
    memory_errors = 0
    
    for address in range(0, MEMORY_SIZE, 4):
        word_index = int(address / 4)
        expected_data = mem_golden_ref[word_index]
        
        # Read from AXI RAM
        mem_data = axi_ram.read(address, 4)
        actual_data = bytes_to_int(mem_data)
        
        if actual_data != expected_data:
            dut._log.error(f"MEMORY MISMATCH at 0x{address:08X}: " +
                          f"expected 0x{expected_data:08X}, got 0x{actual_data:08X}")
            memory_errors += 1

    # ==================================
    # FINAL REPORT
    # ==================================
    dut._log.info("=" * 60)
    dut._log.info(f"READ/WRITE MIXED TEST COMPLETE")
    dut._log.info(f"Total test blocks: {NUM_R_W}")
    dut._log.info(f"Memory verification: {memory_errors} mismatches")
    dut._log.info("=" * 60)
    
    # Assert test passed
    assert memory_errors == 0, f"Memory verification failed with {memory_errors} mismatches"
    dut._log.info("✓ READ/WRITE MIXED TEST PASSED")


# =======================================================================
# =======================================================================
# =======================================================================

@cocotb.test()
async def test_cache_thrashing(dut):
    """Test LRU with addresses mapping to same set (conflict misses)"""
    dut._log.info("=" * 60)
    dut._log.info("TEST: Cache Thrashing (Conflict Misses)")
    dut._log.info("=" * 60)
    
    # Setup
    cocotb.start_soon(Clock(dut.clk, 10, units="ns").start())
    axi_ram = AxiRam(AxiBus.from_prefix(dut, "axi"), dut.clk, dut.rst_n, 
                     size=2**13, reset_active_level=False)
    
    await reset(dut)
    
    # Three addresses mapping to set 0 (bits [8:6] = 000)
    # Address format: [TAG | SET(3bits) | WORD_OFFSET(4bits) | BYTE_OFFSET(2bits)]
    addr_a = 0x000  # Set 0, tag 0
    addr_b = 0x200  # Set 0, tag 1  
    addr_c = 0x400  # Set 0, tag 2
    
    data_a = 0xAAAAAAAA
    data_b = 0xBBBBBBBB
    data_c = 0xCCCCCCCC
    
    # Initialize memory
    axi_ram.write(addr_a, int_to_bytes(data_a))
    axi_ram.write(addr_b, int_to_bytes(data_b))
    axi_ram.write(addr_c, int_to_bytes(data_c))
    
    # Load A and B (fills both ways of set 0)
    dut._log.info("Loading A and B into set 0")
    result = await cpu_read(dut, addr_a)
    assert result == data_a
    result = await cpu_read(dut, addr_b)
    assert result == data_b
    
    # Access A again to make B the LRU
    dut._log.info("Accessing A again (makes B LRU)")
    result = await cpu_read(dut, addr_a)
    assert result == data_a
    
    # Load C - should evict B (LRU)
    dut._log.info("Loading C (should evict B)")
    result = await cpu_read(dut, addr_c)
    assert result == data_c
    
    # A should still be cached
    dut._log.info("Verifying A still cached")
    result = await cpu_read(dut, addr_a)
    assert result == data_a
    
    # B should cause a miss (was evicted)
    dut._log.info("Reading B (should MISS - was evicted)")
    result = await cpu_read(dut, addr_b)
    assert result == data_b
    
    dut._log.info("✓ Cache thrashing test passed")

# =======================================================================
# =======================================================================
# =======================================================================

@cocotb.test()
async def test_dirty_line_eviction(dut):
    """Test that dirty lines are written back on eviction"""
    dut._log.info("=" * 60)
    dut._log.info("TEST: Dirty Line Eviction")
    dut._log.info("=" * 60)
    
    # Setup
    cocotb.start_soon(Clock(dut.clk, 10, units="ns").start())
    axi_ram = AxiRam(AxiBus.from_prefix(dut, "axi"), dut.clk, dut.rst_n,
                     size=2**13, reset_active_level=False)
    
    await reset(dut)
    
    addr1 = 0x000
    addr2 = 0x200  # Same set as addr1
    addr3 = 0x400  # Same set, will evict
    
    initial_data = 0x11111111
    modified_data = 0x99999999
    addr2_data = 0x22222222
    addr3_data = 0x33333333
    
    # Initialize
    axi_ram.write(addr1, int_to_bytes(initial_data))
    axi_ram.write(addr2, int_to_bytes(addr2_data))
    axi_ram.write(addr3, int_to_bytes(addr3_data))
    
    # Load and modify addr1 (makes it dirty)
    dut._log.info("Loading and modifying addr1 (dirty)")
    await cpu_read(dut, addr1)
    await cpu_write(dut, addr1, modified_data)
    
    # Load addr2 (fills second way)
    dut._log.info("Loading addr2")
    await cpu_read(dut, addr2)
    
    # Access addr2 again to make addr1 LRU
    await cpu_read(dut, addr2)
    
    # Load addr3 - should evict dirty addr1 with write-back
    dut._log.info("Loading addr3 (should evict dirty addr1 with WB)")
    await cpu_read(dut, addr3)
    
    # Wait for potential write-back
    await ClockCycles(dut.clk, 50)
    
    # Verify addr1 was written back to memory
    mem_data = axi_ram.read(addr1, 4)
    actual = bytes_to_int(mem_data)
    
    dut._log.info(f"Checking memory: expected 0x{modified_data:08X}, got 0x{actual:08X}")
    assert actual == modified_data, f"Dirty line not written back!"
    
    dut._log.info("✓ Dirty line eviction test passed")

# =======================================================================
# =======================================================================
# =======================================================================

@cocotb.test()
async def test_burst_boundaries(dut):
    """Test reading multiple words within same cache line"""
    dut._log.info("=" * 60)
    dut._log.info("TEST: Burst Boundaries (Same Line Access)")
    dut._log.info("=" * 60)
    
    # Setup
    cocotb.start_soon(Clock(dut.clk, 10, units="ns").start())
    axi_ram = AxiRam(AxiBus.from_prefix(dut, "axi"), dut.clk, dut.rst_n,
                     size=2**13, reset_active_level=False)
    
    await reset(dut)
    
    base_addr = 0x100
    
    # Initialize a full cache line (16 words = 64 bytes)
    golden = []
    for i in range(16):
        data = 0x1000 + i
        axi_ram.write(base_addr + (i * 4), int_to_bytes(data))
        golden.append(data)
    
    # First read should MISS
    dut._log.info(f"First read at 0x{base_addr:08X} (should MISS)")
    result = await cpu_read(dut, base_addr)
    assert result == golden[0]
    
    # All subsequent reads in same line should HIT
    dut._log.info("Reading all 16 words in same line (should all HIT)")
    for i in range(1, 16):
        addr = base_addr + (i * 4)
        result = await cpu_read(dut, addr)
        assert result == golden[i], f"Word {i} mismatch"

    # TODO : add actual hit assertions, for now, data integrity will do
    
    dut._log.info("✓ Burst boundaries test passed")

# =======================================================================
# =======================================================================
# =======================================================================

@cocotb.test()
async def test_write_after_read_same_line(dut):
    """Test write-after-read on same cache line"""
    dut._log.info("=" * 60)
    dut._log.info("TEST: Write-After-Read Same Line")
    dut._log.info("=" * 60)
    
    # Setup
    cocotb.start_soon(Clock(dut.clk, 10, units="ns").start())
    axi_ram = AxiRam(AxiBus.from_prefix(dut, "axi"), dut.clk, dut.rst_n,
                     size=2**13, reset_active_level=False)
    
    await reset(dut)
    
    base_addr = 0x200
    
    # Initialize memory
    for i in range(16):
        axi_ram.write(base_addr + (i * 4), int_to_bytes(0x1000 + i))
    
    # 1. Read address (miss, loads line)
    dut._log.info(f"Read 0x{base_addr:08X} (MISS)")
    result = await cpu_read(dut, base_addr)
    assert result == 0x1000
    
    # 2. Write to base_addr+4 (same line, should HIT)
    new_data = 0xDEADBEEF
    dut._log.info(f"Write to 0x{base_addr+4:08X} (should HIT, same line)")
    await cpu_write(dut, base_addr + 4, new_data)
    
    # 3. Read base_addr+8 (same line, should HIT)
    dut._log.info(f"Read 0x{base_addr+8:08X} (should HIT, same line)")
    result = await cpu_read(dut, base_addr + 8)
    assert result == 0x1002
    
    # 4. Verify the write stuck
    result = await cpu_read(dut, base_addr + 4)
    assert result == new_data
    
    dut._log.info("✓ Write-after-read same line test passed")

# =======================================================================
# =======================================================================
# =======================================================================

@cocotb.test()
async def test_cache_saturation(dut):
    """Test filling all cache lines then forcing replacement"""
    dut._log.info("=" * 60)
    dut._log.info("TEST: Cache Saturation")
    dut._log.info("=" * 60)
    
    # Setup
    cocotb.start_soon(Clock(dut.clk, 10, units="ns").start())
    axi_ram = AxiRam(AxiBus.from_prefix(dut, "axi"), dut.clk, dut.rst_n,
                     size=2**13, reset_active_level=False)
    
    await reset(dut)
    
    # Fill entire cache: 2 ways × 8 sets = 16 unique cache lines
    # Each line is 64 bytes, so addresses 0x000, 0x040, 0x080, ... for set 0
    # Then 0x200, 0x240, 0x280, ... for set 0 way 1
    # Then 0x040, 0x080, ... for set 1, etc.
    
    filled_addresses = []
    
    # Fill way 0: 8 sets
    dut._log.info("Filling way 0 (8 sets)")
    for set_idx in range(8):
        addr = (set_idx << 6)  # Set index in bits [8:6]
        data = 0x1000 + set_idx
        axi_ram.write(addr, int_to_bytes(data))
        result = await cpu_read(dut, addr)
        assert result == data
        filled_addresses.append((addr, data))
    
    # Fill way 1: 8 sets (different tags)
    dut._log.info("Filling way 1 (8 sets)")
    for set_idx in range(8):
        addr = (0x200) | (set_idx << 6)  # Different tag
        data = 0x2000 + set_idx
        axi_ram.write(addr, int_to_bytes(data))
        result = await cpu_read(dut, addr)
        assert result == data
        filled_addresses.append((addr, data))
    
    # Cache is now full (16 lines)
    dut._log.info("Cache full with 16 lines")
    
    # Load a 17th line - should evict one line
    new_addr = 0x400  # Maps to set 0, will evict LRU
    new_data = 0x9999
    axi_ram.write(new_addr, int_to_bytes(new_data))
    
    dut._log.info(f"Loading 17th line at 0x{new_addr:08X} (forces eviction)")
    result = await cpu_read(dut, new_addr)
    assert result == new_data
    
    # Verify one line was evicted (would cause a miss)
    # The first address in set 0 should have been evicted
    dut._log.info("Verifying eviction occurred")
    result = await cpu_read(dut, filled_addresses[0][0])
    assert result == filled_addresses[0][1]
    
    dut._log.info("✓ Cache saturation test passed")


@cocotb.test()
async def test_read_modify_write_sequence(dut):
    """Test read-modify-write pattern"""
    dut._log.info("=" * 60)
    dut._log.info("TEST: Read-Modify-Write Sequence")
    dut._log.info("=" * 60)
    
    # Setup
    cocotb.start_soon(Clock(dut.clk, 10, units="ns").start())
    axi_ram = AxiRam(AxiBus.from_prefix(dut, "axi"), dut.clk, dut.rst_n,
                     size=2**13, reset_active_level=False)
    
    await reset(dut)
    
    addr = 0x300
    initial = 0x12345678
    
    axi_ram.write(addr, int_to_bytes(initial))
    
    # Read
    dut._log.info(f"Read: 0x{addr:08X}")
    old_val = await cpu_read(dut, addr)
    assert old_val == initial
    
    # Modify
    new_val = old_val ^ 0xAAAAAAAA
    dut._log.info(f"Modify: 0x{old_val:08X} XOR 0xAAAAAAAA = 0x{new_val:08X}")
    
    # Write
    await cpu_write(dut, addr, new_val)
    
    # Verify
    result = await cpu_read(dut, addr)
    assert result == new_val
    
    dut._log.info("✓ Read-modify-write sequence test passed")


@cocotb.test()
async def test_all_sets_access(dut):
    """Test accessing all sets in random order"""
    dut._log.info("=" * 60)
    dut._log.info("TEST: All Sets Random Access")
    dut._log.info("=" * 60)
    
    # Setup
    cocotb.start_soon(Clock(dut.clk, 10, units="ns").start())
    axi_ram = AxiRam(AxiBus.from_prefix(dut, "axi"), dut.clk, dut.rst_n,
                     size=2**13, reset_active_level=False)
    
    await reset(dut)
    
    # Create addresses for all 8 sets with random tags
    set_addresses = []
    for set_idx in range(8):
        addr = (set_idx << 6)  # Juste le set index, tag = 0
        data = 0xA000 + set_idx
        axi_ram.write(addr, data.to_bytes(4, byteorder='little'))
        set_addresses.append((addr, data))
    
    # Shuffle and access
    random.shuffle(set_addresses)
    
    dut._log.info("Accessing all 8 sets in random order")
    for addr, expected in set_addresses:
        result = await cpu_read(dut, addr)
        assert result == expected, f"Set access failed at 0x{addr:08X}"
    
    dut._log.info("✓ All sets random access test passed")


@cocotb.test()
async def test_rapid_read_write_toggle(dut):
    """Test rapid toggling between reads and writes"""
    dut._log.info("=" * 60)
    dut._log.info("TEST: Rapid Read/Write Toggle")
    dut._log.info("=" * 60)
    
    # Setup
    cocotb.start_soon(Clock(dut.clk, 10, units="ns").start())
    axi_ram = AxiRam(AxiBus.from_prefix(dut, "axi"), dut.clk, dut.rst_n,
                     size=2**13, reset_active_level=False)
    
    await reset(dut)
    
    addr = 0x400
    
    # Initialize
    axi_ram.write(addr, int_to_bytes(0))
    
    # Rapid R/W/R/W pattern
    dut._log.info("Performing rapid R/W/R/W pattern")
    for i in range(10):
        # Read
        val = await cpu_read(dut, addr)
        # Write
        await cpu_write(dut, addr, val + 1)
        # Read again
        val = await cpu_read(dut, addr)
        assert val == i + 1
    
    dut._log.info("✓ Rapid read/write toggle test passed")



# =============================================================================
# TEST 1: Address Change During Miss
# =============================================================================

# This test specifically targets Bug #1: the bram_rdata mux uses hit_way0/hit_way1
# which are based on the CURRENT address, not the pending address.

# Scenario:
# 1. CPU requests read at address A (causes miss)
# 2. While cache is fetching A from memory, CPU CHANGES address input to B
# 3. When READ_OK happens, hit detection looks at B, not A
# 4. Wrong way might be selected, returning wrong data
# =============================================================================

@cocotb.test()
async def test_address_change_during_miss(dut):
    """
    Test the critical bug: address input changes while miss is being serviced.
    
    This directly mimics CPU behavior where the address bus shows the NEXT
    instruction's address while the cache is still servicing the current miss.
    """
    dut._log.info("=" * 70)
    dut._log.info("TEST: Address Change During Miss")
    dut._log.info("Mimics CPU changing address while cache services a miss")
    dut._log.info("=" * 70)
    
    cocotb.start_soon(Clock(dut.clk, CPU_PERIOD, units="ns").start())
    axi_ram = AxiRam(AxiBus.from_prefix(dut, "axi"), dut.clk, dut.rst_n,
                     size=MEMORY_SIZE, reset_active_level=False)
    
    await reset(dut)
    
    errors = 0
    
    # Setup: Two addresses in the SAME SET but different tags
    # After both are loaded, they'll be in different ways
    addr_A = 0x000  # Set 0, Tag 0 -> will be in way 0
    addr_B = 0x200  # Set 0, Tag 1 -> will be in way 1
    addr_C = 0x400  # Set 0, Tag 2 -> will cause eviction
    
    data_A = 0xAAAA0000
    data_B = 0xBBBB0000
    data_C = 0xCCCC0000
    
    # Initialize memory
    axi_ram.write(addr_A, int_to_bytes(data_A))
    axi_ram.write(addr_B, int_to_bytes(data_B))
    axi_ram.write(addr_C, int_to_bytes(data_C))
    
    # Pre-load A and B into cache
    dut._log.info("Pre-loading A and B into cache (same set, different ways)")
    result = await cpu_read(dut, addr_A)
    assert result == data_A, f"Pre-load A failed"
    result = await cpu_read(dut, addr_B)
    assert result == data_B, f"Pre-load B failed"
    
    # Make A the LRU by accessing B
    await cpu_read(dut, addr_B)
    
    dut._log.info("Now testing: Request C (miss), change address to B during fetch")
    
    # Start a read request for C (will miss and evict A)
    dut.cpu_address.value = addr_C
    dut.cpu_req_valid.value = 1
    dut.cpu_req_write.value = 0
    dut.cpu_byte_enable.value = 0xF
    dut.cpu_read_ack.value = 1
    
    # Wait for request to be accepted
    await RisingEdge(dut.clk)
    while dut.cpu_req_ready.value == 0:
        await RisingEdge(dut.clk)
    
    # Request accepted - now CHANGE THE ADDRESS to B while miss is being serviced!
    # This is what a real CPU might do - show next address on the bus
    dut.cpu_req_valid.value = 0
    dut.cpu_address.value = addr_B  # <-- CRITICAL: Change address during miss!
    
    dut._log.info(f"Address changed to 0x{addr_B:08X} while servicing miss for 0x{addr_C:08X}")
    
    # Wait for read_valid
    cycle_count = 0
    while dut.cpu_read_valid.value == 0:
        await RisingEdge(dut.clk)
        cycle_count += 1
        if cycle_count > 500:
            raise Exception("Timeout waiting for read_valid")
    
    # Check the result - should be data_C (what we requested), NOT data_B!
    result = int(dut.cpu_read_data.value)
    
    dut._log.info(f"Requested addr 0x{addr_C:08X} (data_C=0x{data_C:08X})")
    dut._log.info(f"Address during fetch was 0x{addr_B:08X} (data_B=0x{data_B:08X})")
    dut._log.info(f"Got result: 0x{result:08X}")
    
    if result == data_B:
        dut._log.error("BUG CONFIRMED: Got data_B instead of data_C!")
        dut._log.error("The cache used the CURRENT address for hit detection, not pending!")
        errors += 1
    elif result != data_C:
        dut._log.error(f"Got unexpected data: 0x{result:08X}")
        errors += 1
    else:
        dut._log.info("Correct: Got data_C as expected")
    
    await RisingEdge(dut.clk)
    
    # Additional verification: Can we still read B correctly?
    dut._log.info("Verifying B is still accessible and correct...")
    result = await cpu_read(dut, addr_B)
    if result != data_B:
        dut._log.error(f"B corrupted: got 0x{result:08X}, expected 0x{data_B:08X}")
        errors += 1
    
    assert errors == 0, f"Address change during miss test failed with {errors} errors"
    dut._log.info("✓ Address change during miss test PASSED")


# =============================================================================
# TEST 2: Rapid Back-to-Back Byte-Enable Writes
# =============================================================================

@cocotb.test()
async def test_rapid_byte_enable_writes(dut):
    """
    Test rapid partial-word writes like DOOM's framebuffer updates.
    
    DOOM often writes individual bytes or half-words rapidly to the
    same cache line.
    """
    dut._log.info("=" * 70)
    dut._log.info("TEST: Rapid Byte-Enable Writes")
    dut._log.info("Mimics DOOM framebuffer byte/halfword writes")
    dut._log.info("=" * 70)
    
    cocotb.start_soon(Clock(dut.clk, CPU_PERIOD, units="ns").start())
    axi_ram = AxiRam(AxiBus.from_prefix(dut, "axi"), dut.clk, dut.rst_n,
                     size=MEMORY_SIZE, reset_active_level=False)
    
    await reset(dut)
    
    errors = 0
    base_addr = 0x1000
    
    # Initialize a cache line
    for word in range(16):
        axi_ram.write(base_addr + word * 4, int_to_bytes(0xFFFFFFFF))
    
    # Load the line into cache
    await cpu_read(dut, base_addr)
    
    # Track expected values
    expected = [0xFFFFFFFF] * 16
    
    dut._log.info("Performing rapid byte-enable writes...")
    
    # Simulate framebuffer-style writes: lots of partial updates
    for iteration in range(50):
        word_idx = random.randint(0, 15)
        addr = base_addr + word_idx * 4
        
        # Random byte enable pattern
        be = random.randint(1, 15)
        write_val = random.randint(0, 0xFFFFFFFF)
        
        # Perform write
        await cpu_write(dut, addr, write_val, byte_enable=be)
        
        # Update expected
        old_val = expected[word_idx]
        new_val = old_val
        if be & 0x1:
            new_val = (new_val & 0xFFFFFF00) | (write_val & 0x000000FF)
        if be & 0x2:
            new_val = (new_val & 0xFFFF00FF) | (write_val & 0x0000FF00)
        if be & 0x4:
            new_val = (new_val & 0xFF00FFFF) | (write_val & 0x00FF0000)
        if be & 0x8:
            new_val = (new_val & 0x00FFFFFF) | (write_val & 0xFF000000)
        expected[word_idx] = new_val
    
    # Verify all words
    dut._log.info("Verifying all words in cache line...")
    for word_idx in range(16):
        addr = base_addr + word_idx * 4
        result = await cpu_read(dut, addr)
        if result != expected[word_idx]:
            dut._log.error(f"Word {word_idx}: got 0x{result:08X}, expected 0x{expected[word_idx]:08X}")
            errors += 1
    
    # Flush and verify memory
    dut._log.info("Flushing and verifying memory...")
    await flush_cache(dut)
    
    for word_idx in range(16):
        addr = base_addr + word_idx * 4
        mem_data = bytes_to_int(axi_ram.read(addr, 4))
        if mem_data != expected[word_idx]:
            dut._log.error(f"Memory word {word_idx}: got 0x{mem_data:08X}, expected 0x{expected[word_idx]:08X}")
            errors += 1
    
    assert errors == 0, f"Rapid byte-enable writes failed with {errors} errors"
    dut._log.info("✓ Rapid byte-enable writes test PASSED")


# =============================================================================
# TEST 3: Back-to-Back Requests Without Waiting
# =============================================================================

@cocotb.test()
async def test_back_to_back_no_wait(dut):
    """
    Test back-to-back requests where CPU doesn't wait between operations.
    
    Real CPUs often pipeline: while one request is completing, the next
    address is already on the bus.
    """
    dut._log.info("=" * 70)
    dut._log.info("TEST: Back-to-Back Requests Without Waiting")
    dut._log.info("Mimics pipelined CPU behavior")
    dut._log.info("=" * 70)
    
    cocotb.start_soon(Clock(dut.clk, CPU_PERIOD, units="ns").start())
    axi_ram = AxiRam(AxiBus.from_prefix(dut, "axi"), dut.clk, dut.rst_n,
                     size=MEMORY_SIZE, reset_active_level=False)
    
    await reset(dut)
    
    errors = 0
    golden = {}
    
    # Initialize memory region
    for addr in range(0, 0x1000, 4):
        data = 0xBA5E0000 | addr
        axi_ram.write(addr, int_to_bytes(data))
        golden[addr] = data
    
    # Pre-load some cache lines
    dut._log.info("Pre-loading cache lines...")
    for addr in [0x000, 0x040, 0x080, 0x0C0]:
        await cpu_read(dut, addr)
    
    dut._log.info("Testing back-to-back reads across cache lines...")
    
    # Rapid sequential reads - address changes immediately after acceptance
    test_addrs = [0x000, 0x004, 0x044, 0x008, 0x084, 0x00C, 0x04C, 0x088]
    
    for i, addr in enumerate(test_addrs):
        # Set up request
        dut.cpu_address.value = addr
        dut.cpu_req_valid.value = 1
        dut.cpu_req_write.value = 0
        dut.cpu_byte_enable.value = 0xF
        dut.cpu_read_ack.value = 1
        
        await RisingEdge(dut.clk)
        
        # Wait for acceptance
        while dut.cpu_req_ready.value == 0:
            await RisingEdge(dut.clk)
        
        # Immediately change address to NEXT request (pipelined behavior)
        next_addr = test_addrs[(i + 1) % len(test_addrs)]
        dut.cpu_address.value = next_addr
        dut.cpu_req_valid.value = 0
        
        # Wait for data
        while dut.cpu_read_valid.value == 0:
            await RisingEdge(dut.clk)
        
        result = int(dut.cpu_read_data.value)
        expected = golden[addr]
        
        if result != expected:
            dut._log.error(f"Addr 0x{addr:03X}: got 0x{result:08X}, expected 0x{expected:08X}")
            errors += 1
        
        await RisingEdge(dut.clk)
    
    assert errors == 0, f"Back-to-back requests failed with {errors} errors"
    dut._log.info("✓ Back-to-back requests test PASSED")


# =============================================================================
# TEST 4: Mixed Read/Write with Address Changes
# =============================================================================

@cocotb.test()
async def test_mixed_rw_address_changes(dut):
    """
    Test mixed reads and writes with address changing during operations.
    
    This combines all the aggressive behaviors:
    - Byte enables
    - Address changes during miss
    - Back-to-back operations
    - Mix of reads and writes
    """
    dut._log.info("=" * 70)
    dut._log.info("TEST: Mixed R/W with Address Changes")
    dut._log.info("Ultimate stress test combining all aggressive behaviors")
    dut._log.info("=" * 70)
    
    cocotb.start_soon(Clock(dut.clk, CPU_PERIOD, units="ns").start())
    axi_ram = AxiRam(AxiBus.from_prefix(dut, "axi"), dut.clk, dut.rst_n,
                     size=MEMORY_SIZE, reset_active_level=False)
    
    await reset(dut)
    
    errors = 0
    golden = {}
    
    # Initialize memory
    for addr in range(0, 0x2000, 4):
        data = random.randint(0, 0xFFFFFFFF)
        axi_ram.write(addr, int_to_bytes(data))
        golden[addr] = data
    
    NUM_OPS = 500
    dut._log.info(f"Performing {NUM_OPS} mixed operations...")
    
    for op_num in range(NUM_OPS):
        # Pick random address
        addr = random.randint(0, 0x1FFF) & ~3
        
        # Decide operation
        is_write = random.random() < 0.4
        
        if is_write:
            # Write with random byte enable
            be = random.randint(1, 15)
            write_val = random.randint(0, 0xFFFFFFFF)
            
            dut.cpu_address.value = addr
            dut.cpu_write_data.value = write_val
            dut.cpu_req_valid.value = 1
            dut.cpu_req_write.value = 1
            dut.cpu_byte_enable.value = be
            
            await RisingEdge(dut.clk)
            while dut.cpu_req_ready.value == 0:
                await RisingEdge(dut.clk)
            
            # Change address immediately (pipelined)
            other_addr = random.randint(0, 0x1FFF) & ~3
            dut.cpu_address.value = other_addr
            dut.cpu_req_valid.value = 0
            dut.cpu_req_write.value = 0
            
            # Update golden
            old_val = golden[addr]
            new_val = old_val
            if be & 0x1:
                new_val = (new_val & 0xFFFFFF00) | (write_val & 0x000000FF)
            if be & 0x2:
                new_val = (new_val & 0xFFFF00FF) | (write_val & 0x0000FF00)
            if be & 0x4:
                new_val = (new_val & 0xFF00FFFF) | (write_val & 0x00FF0000)
            if be & 0x8:
                new_val = (new_val & 0x00FFFFFF) | (write_val & 0xFF000000)
            golden[addr] = new_val
            
            await RisingEdge(dut.clk)
            
        else:
            # Read
            dut.cpu_address.value = addr
            dut.cpu_req_valid.value = 1
            dut.cpu_req_write.value = 0
            dut.cpu_byte_enable.value = 0xF
            dut.cpu_read_ack.value = 1
            
            await RisingEdge(dut.clk)
            while dut.cpu_req_ready.value == 0:
                await RisingEdge(dut.clk)
            
            # Change address immediately
            other_addr = random.randint(0, 0x1FFF) & ~3
            dut.cpu_address.value = other_addr
            dut.cpu_req_valid.value = 0
            
            # Wait for data
            timeout = 0
            while dut.cpu_read_valid.value == 0:
                await RisingEdge(dut.clk)
                timeout += 1
                if timeout > 500:
                    raise Exception(f"Timeout on op {op_num}")
            
            result = int(dut.cpu_read_data.value)
            expected = golden[addr]
            
            if result != expected:
                dut._log.error(f"Op {op_num}: Read 0x{addr:04X} got 0x{result:08X}, expected 0x{expected:08X}")
                errors += 1
            
            await RisingEdge(dut.clk)
        
        if (op_num + 1) % 100 == 0:
            dut._log.info(f"Progress: {op_num + 1}/{NUM_OPS}, errors: {errors}")
    
    # Final verification via flush
    dut._log.info("Flushing and verifying memory...")
    await flush_cache(dut)
    
    sample = random.sample(list(golden.keys()), 200)
    for addr in sample:
        mem_data = bytes_to_int(axi_ram.read(addr, 4))
        if mem_data != golden[addr]:
            errors += 1
    
    assert errors == 0, f"Mixed R/W test failed with {errors} errors"
    dut._log.info("✓ Mixed R/W test PASSED")


# =============================================================================
# TEST 5: Specific DOOM-like Pattern - Framebuffer + Texture Access
# =============================================================================

@cocotb.test()
async def test_doom_framebuffer_texture(dut):
    """
    Simulates DOOM's actual access pattern:
    - Write pixels to framebuffer (often byte writes)
    - Read textures (scattered reads)
    - Both happening in rapid succession with address changes
    """
    dut._log.info("=" * 70)
    dut._log.info("TEST: DOOM Framebuffer + Texture Pattern")
    dut._log.info("=" * 70)
    
    cocotb.start_soon(Clock(dut.clk, CPU_PERIOD, units="ns").start())
    axi_ram = AxiRam(AxiBus.from_prefix(dut, "axi"), dut.clk, dut.rst_n,
                     size=MEMORY_SIZE, reset_active_level=False)
    
    await reset(dut)
    
    errors = 0
    
    # Memory layout
    FRAMEBUFFER = 0x00000  # Framebuffer at 0x00000
    TEXTURE = 0x10000      # Texture at 0x10000
    
    golden_fb = {}
    golden_tex = {}
    
    # Initialize framebuffer (black)
    for addr in range(FRAMEBUFFER, FRAMEBUFFER + 0x4000, 4):
        axi_ram.write(addr, int_to_bytes(0x00000000))
        golden_fb[addr] = 0x00000000
    
    # Initialize texture with pattern
    for addr in range(TEXTURE, TEXTURE + 0x4000, 4):
        data = 0x7EAD0000 | (addr & 0xFFFF)
        axi_ram.write(addr, int_to_bytes(data))
        golden_tex[addr] = data
    
    dut._log.info("Simulating DOOM rendering loop...")
    
    NUM_COLUMNS = 50
    
    for column in range(NUM_COLUMNS):
        # For each column, DOOM:
        # 1. Reads texture data (scattered across texture memory)
        # 2. Writes pixels to framebuffer (potentially byte writes)
        
        # Texture reads for this column (simulating wall texture lookup)
        tex_samples = []
        for y in range(8):
            tex_addr = TEXTURE + ((column * 64 + y * 8) % 0x4000)
            tex_addr = tex_addr & ~3
            
            # Read texture - with address changing after acceptance
            dut.cpu_address.value = tex_addr
            dut.cpu_req_valid.value = 1
            dut.cpu_req_write.value = 0
            dut.cpu_byte_enable.value = 0xF
            dut.cpu_read_ack.value = 1
            
            await RisingEdge(dut.clk)
            while dut.cpu_req_ready.value == 0:
                await RisingEdge(dut.clk)
            
            # Change address to next texture coord (pipelined)
            next_tex_addr = TEXTURE + (((column * 64 + (y+1) * 8) % 0x4000) & ~3)
            dut.cpu_address.value = next_tex_addr
            dut.cpu_req_valid.value = 0
            
            while dut.cpu_read_valid.value == 0:
                await RisingEdge(dut.clk)
            
            tex_data = int(dut.cpu_read_data.value)
            
            if tex_data != golden_tex[tex_addr]:
                dut._log.error(f"Column {column}: Texture read error at 0x{tex_addr:08X}")
                errors += 1
            
            tex_samples.append(tex_data & 0xFF)  # Just use low byte as "color"
            
            await RisingEdge(dut.clk)
        
        # Now write pixels to framebuffer
        for y, color in enumerate(tex_samples):
            fb_addr = FRAMEBUFFER + (column + y * 320) * 4
            fb_addr = fb_addr % 0x4000 + FRAMEBUFFER
            fb_addr = fb_addr & ~3
            
            # Byte write (just one byte of the pixel)
            byte_pos = column % 4
            be = 1 << byte_pos
            write_val = color << (byte_pos * 8)
            
            dut.cpu_address.value = fb_addr
            dut.cpu_write_data.value = write_val
            dut.cpu_req_valid.value = 1
            dut.cpu_req_write.value = 1
            dut.cpu_byte_enable.value = be
            
            await RisingEdge(dut.clk)
            while dut.cpu_req_ready.value == 0:
                await RisingEdge(dut.clk)
            
            # Update golden
            old_val = golden_fb[fb_addr]
            mask = 0xFF << (byte_pos * 8)
            golden_fb[fb_addr] = (old_val & ~mask) | (write_val & mask)
            
            # Change address (pipelined)
            dut.cpu_address.value = TEXTURE
            dut.cpu_req_valid.value = 0
            dut.cpu_req_write.value = 0
            
            await RisingEdge(dut.clk)
        
        if (column + 1) % 10 == 0:
            dut._log.info(f"Rendered {column + 1}/{NUM_COLUMNS} columns, errors: {errors}")
    
    # Flush and verify framebuffer
    dut._log.info("Flushing and verifying framebuffer...")
    await flush_cache(dut)
    
    for addr, expected in golden_fb.items():
        mem_data = bytes_to_int(axi_ram.read(addr, 4))
        if mem_data != expected:
            dut._log.error(f"FB mismatch at 0x{addr:08X}: got 0x{mem_data:08X}, expected 0x{expected:08X}")
            errors += 1
            if errors > 20:
                dut._log.error("Too many errors, stopping verification")
                break
    
    assert errors == 0, f"DOOM pattern test failed with {errors} errors"
    dut._log.info("✓ DOOM pattern test PASSED")


# =============================================================================
# TEST 6: Write Miss with Address Change (Critical!)
# =============================================================================

@cocotb.test()
async def test_write_miss_address_change(dut):
    """
    Test write miss where address changes during the miss handling.
    
    This is potentially more dangerous than read miss because:
    - Cache fetches line from memory
    - Then applies the pending write
    - If wrong metadata is used, wrong location gets written
    """
    dut._log.info("=" * 70)
    dut._log.info("TEST: Write Miss with Address Change")
    dut._log.info("Tests pending write is applied to correct location")
    dut._log.info("=" * 70)
    
    cocotb.start_soon(Clock(dut.clk, CPU_PERIOD, units="ns").start())
    axi_ram = AxiRam(AxiBus.from_prefix(dut, "axi"), dut.clk, dut.rst_n,
                     size=MEMORY_SIZE, reset_active_level=False)
    
    await reset(dut)
    
    errors = 0
    
    # Two addresses in same set
    addr_A = 0x000
    addr_B = 0x200
    
    # Initialize with known values
    axi_ram.write(addr_A, int_to_bytes(0x11111111))
    axi_ram.write(addr_B, int_to_bytes(0x22222222))
    
    # Load B into cache (so A will miss)
    await cpu_read(dut, addr_B)
    
    dut._log.info("Testing write miss with address change...")
    
    # Write to A (will miss)
    write_val = 0xDEADBEEF
    
    dut.cpu_address.value = addr_A
    dut.cpu_write_data.value = write_val
    dut.cpu_req_valid.value = 1
    dut.cpu_req_write.value = 1
    dut.cpu_byte_enable.value = 0xF
    
    await RisingEdge(dut.clk)
    while dut.cpu_req_ready.value == 0:
        await RisingEdge(dut.clk)
    
    # Request accepted - NOW CHANGE ADDRESS TO B!
    dut.cpu_address.value = addr_B
    dut.cpu_req_valid.value = 0
    dut.cpu_req_write.value = 0
    
    dut._log.info(f"Write to 0x{addr_A:08X} accepted, address changed to 0x{addr_B:08X}")
    
    # Wait for cache to become ready again (write miss complete)
    await wait_for_ready(dut)
    
    # Verify A has the written value
    dut._log.info("Verifying A has written value...")
    result = await cpu_read(dut, addr_A)
    if result != write_val:
        dut._log.error(f"A: got 0x{result:08X}, expected 0x{write_val:08X}")
        errors += 1
    else:
        dut._log.info(f"A correct: 0x{result:08X}")
    
    # Verify B was NOT corrupted
    dut._log.info("Verifying B was not corrupted...")
    result = await cpu_read(dut, addr_B)
    if result != 0x22222222:
        dut._log.error(f"B CORRUPTED: got 0x{result:08X}, expected 0x22222222")
        errors += 1
    else:
        dut._log.info(f"B correct: 0x{result:08X}")
    
    # Flush and verify memory
    await flush_cache(dut)
    
    mem_A = bytes_to_int(axi_ram.read(addr_A, 4))
    mem_B = bytes_to_int(axi_ram.read(addr_B, 4))
    
    if mem_A != write_val:
        dut._log.error(f"Memory A wrong: 0x{mem_A:08X}")
        errors += 1
    
    if mem_B != 0x22222222:
        dut._log.error(f"Memory B corrupted: 0x{mem_B:08X}")
        errors += 1
    
    assert errors == 0, f"Write miss address change test failed with {errors} errors"
    dut._log.info("✓ Write miss address change test PASSED")


# =============================================================================
# TEST 6 (added oct 2026): Asked AI to pick up some gaps in the test and it dod find some,
# this test is a summary of those gaps tested.
# I shall specify this code is not handwritten and heavily vide coded
#
# The motivation behind this is that I want to tidy up the cache bugs which
# was a very difficult module to write, harder than the core tbh when you are learning
# And it takes a looot of time to fix bug by hands. Becaus I was working on the drone project
# I needed a quick way to fix a simple bug and more importantly check the module againt more test cases.
# Tbh this AI stuff is so good that I ffel like I won't ever have to write a cache again.
# At this point, I'm just thankful I ever got t learn all that, but today, it feels unrelevant to write stuff by hand
# especially when, like me, you moved on a while ago from a specific piece of code
# and would take 1-2 days to pik it back up and fix the bugs, days which I don't have
# Anyway...
# =============================================================================

# =============================================================================
# ADDITIONAL CLAUDE CHECKS  (paste at the end of the existing testbench)
#
# Everything runs with RANDOM AXI BACK-PRESSURE on all 5 channels.
#   1. Hits make no AXI traffic        5. Clean line + RAM changed behind:
#   2. LRU eviction by AXI counts         flush must not overwrite RAM
#   3. Flush writes ONLY dirty lines    6. Full dirty flush under back-pressure
#   4. Second flush writes nothing      7. Delayed read_ack keeps data stable
#                                       8. Reset invalidates the cache
# =============================================================================

from cocotb.triggers import ReadOnly


def _rand_pause(p=0.3):
    """Pause generator for cocotbext-axi: True = stall this cycle."""
    while True:
        yield random.random() < p


class _AxiCounter:
    """Counts completed AR and AW handshakes (one per burst)."""

    def __init__(self, dut):
        self.dut = dut
        self.ar = 0
        self.aw = 0
        cocotb.start_soon(self._run())

    async def _run(self):
        dut = self.dut
        while True:
            await RisingEdge(dut.clk)
            await ReadOnly()
            if dut.axi_arvalid.value == 1 and dut.axi_arready.value == 1:
                self.ar += 1
            if dut.axi_awvalid.value == 1 and dut.axi_awready.value == 1:
                self.aw += 1


async def _cpu_read_slow_ack(dut, address, max_delay=8):
    """Read, hold read_ack low 1..max_delay cycles, check data stays stable."""
    dut.cpu_address.value = address
    dut.cpu_req_valid.value = 1
    dut.cpu_req_write.value = 0
    dut.cpu_byte_enable.value = 0xF
    dut.cpu_read_ack.value = 0

    await RisingEdge(dut.clk)
    while dut.cpu_req_ready.value == 0:
        await RisingEdge(dut.clk)
    dut.cpu_req_valid.value = 0

    while dut.cpu_read_valid.value == 0:
        await RisingEdge(dut.clk)
    first = int(dut.cpu_read_data.value)

    for _ in range(random.randint(1, max_delay)):
        await RisingEdge(dut.clk)
        assert dut.cpu_read_valid.value == 1, "read_valid dropped before read_ack"
        assert int(dut.cpu_read_data.value) == first, "read_data changed while waiting for ack"

    dut.cpu_read_ack.value = 1
    await RisingEdge(dut.clk)
    dut.cpu_read_ack.value = 0
    await RisingEdge(dut.clk)
    return first


def _flush_invalidate_param(dut):
    """FLUSH_INVALIDATE if the simulator exposes it, else None."""
    try:
        return int(dut.cache_system.FLUSH_INVALIDATE.value)
    except Exception:
        return None


@cocotb.test()
async def test_additional_claude_checks(dut):
    """Back-pressure, hit/miss counts, flush semantics, delayed ack, reset."""
    log = dut._log
    log.info("=" * 70)
    log.info("TEST: ADDITIONAL CLAUDE CHECKS (random AXI back-pressure)")
    log.info("=" * 70)

    MEM = 2**16
    cocotb.start_soon(Clock(dut.clk, CPU_PERIOD, units="ns").start())
    axi_ram = AxiRam(AxiBus.from_prefix(dut, "axi"), dut.clk, dut.rst_n,
                     size=MEM, reset_active_level=False)

    for ch in (axi_ram.write_if.aw_channel, axi_ram.write_if.w_channel,
               axi_ram.write_if.b_channel,  axi_ram.read_if.ar_channel,
               axi_ram.read_if.r_channel):
        ch.set_pause_generator(_rand_pause(0.3))

    cnt = _AxiCounter(dut)

    init = bytes(random.getrandbits(8) for _ in range(MEM))
    axi_ram.write(0, init)
    golden = [bytes_to_int(init[a:a + 4]) for a in range(0, MEM, 4)]

    def g(addr):          return golden[addr >> 2]
    def set_g(addr, val): golden[addr >> 2] = val
    def ram(addr):        return bytes_to_int(axi_ram.read(addr, 4))

    await reset(dut)

    # 1. Hits produce no AXI traffic --------------------------------------
    log.info("[1] 1 miss + 15 hits in one line -> exactly 1 AXI read burst")
    base = 0x0100
    ar0 = cnt.ar
    assert await cpu_read(dut, base) == g(base)
    assert cnt.ar - ar0 == 1, f"first read should be 1 line fill, got {cnt.ar - ar0}"
    ar1 = cnt.ar
    for i in range(1, 16):
        a = base + 4 * i
        assert await cpu_read(dut, a) == g(a), f"hit data mismatch at 0x{a:04X}"
    assert cnt.ar == ar1, f"hits caused {cnt.ar - ar1} AXI reads (cache not caching?)"
    log.info("    OK")

    # 2. LRU eviction by AXI counts ---------------------------------------
    log.info("[2] LRU: A, B, A, C (evicts B) -> A hits, B misses")
    await reset(dut)
    A, B, C = 0x0000, 0x0200, 0x0400
    for a in (A, B, A, C):
        assert await cpu_read(dut, a) == g(a)
    ar0 = cnt.ar
    assert await cpu_read(dut, A) == g(A)
    assert cnt.ar == ar0, "A should still be cached"
    assert await cpu_read(dut, B) == g(B)
    assert cnt.ar == ar0 + 1, "B should have been evicted"
    log.info("    OK")

    # 3. Flush writes back ONLY dirty lines -------------------------------
    log.info("[3] 3 dirty + 3 clean lines -> flush = exactly 3 write bursts")
    await reset(dut)
    dirty_lines = [0x1000, 0x1040, 0x1080]
    clean_lines = [0x20C0, 0x2100, 0x2140]
    for a in dirty_lines:
        v = random.getrandbits(32)
        await cpu_write(dut, a, v)
        set_g(a, v)
    for a in clean_lines:
        assert await cpu_read(dut, a) == g(a)
    aw0 = cnt.aw
    await flush_cache(dut)
    assert cnt.aw - aw0 == 3, f"flush wrote {cnt.aw - aw0} lines, expected 3"
    for a in dirty_lines + clean_lines:
        assert ram(a) == g(a), f"RAM mismatch at 0x{a:04X} after flush"
    log.info("    OK")

    # 4. Second flush writes nothing --------------------------------------
    log.info("[4] immediate second flush -> 0 write bursts")
    aw0 = cnt.aw
    await flush_cache(dut)
    assert cnt.aw == aw0, f"second flush wrote {cnt.aw - aw0} lines"
    log.info("    OK")

    # 5. Clean line + RAM changed behind the cache ------------------------
    log.info("[5] clean line, RAM changed behind cache, flush must not overwrite")
    await reset(dut)
    X = 0x3000
    assert await cpu_read(dut, X) == g(X)
    newv = g(X) ^ 0xFFFFFFFF
    axi_ram.write(X, int_to_bytes(newv))
    set_g(X, newv)
    await flush_cache(dut)
    assert ram(X) == newv, "flush wrote a CLEAN line back over newer RAM content"
    fi = _flush_invalidate_param(dut)
    if fi == 1:
        ar0 = cnt.ar
        assert await cpu_read(dut, X) == newv, "after invalidating flush, read must see RAM"
        assert cnt.ar == ar0 + 1, "after invalidating flush, read must miss"
        log.info("    FLUSH_INVALIDATE=1 verified")
    else:
        log.info(f"    FLUSH_INVALIDATE={fi}: invalidate sub-check skipped")
    log.info("    OK")

    # 6. Whole cache dirty, flush under back-pressure ---------------------
    log.info("[6] 16 fully dirty lines, flush, compare 256 words")
    await reset(dut)
    lines = [0x4000 + s * 0x40 for s in range(8)] + [0x4200 + s * 0x40 for s in range(8)]
    for la in lines:
        for w in range(16):
            a = la + 4 * w
            v = random.getrandbits(32)
            await cpu_write(dut, a, v)
            set_g(a, v)
    aw0 = cnt.aw
    await flush_cache(dut)
    assert cnt.aw - aw0 == 16, f"expected 16 write-back bursts, got {cnt.aw - aw0}"
    bad = [la + 4 * w for la in lines for w in range(16) if ram(la + 4 * w) != g(la + 4 * w)]
    assert not bad, f"{len(bad)} words corrupted by flush, first at 0x{bad[0]:04X}"
    log.info("    OK")

    # 7. Delayed read_ack -------------------------------------------------
    log.info("[7] 100 reads with read_ack delayed 1..8 cycles")
    await reset(dut)
    for _ in range(100):
        a = random.randint(0, (MEM // 4) - 1) * 4
        assert await _cpu_read_slow_ack(dut, a) == g(a), f"slow-ack mismatch at 0x{a:04X}"
    dut.cpu_read_ack.value = 1
    log.info("    OK")

    # 8. Reset invalidates the cache --------------------------------------
    log.info("[8] cached line, RAM changed behind, reset -> read sees new RAM")
    Y = 0x5000
    assert await cpu_read(dut, Y) == g(Y)
    newv = g(Y) ^ 0x5A5A5A5A
    axi_ram.write(Y, int_to_bytes(newv))
    set_g(Y, newv)
    await reset(dut)
    ar0 = cnt.ar
    assert await cpu_read(dut, Y) == newv, "after reset the cache returned stale data"
    assert cnt.ar == ar0 + 1, "after reset the first read must miss"
    log.info("    OK")

    log.info("=" * 70)
    log.info("ALL ADDITIONAL CLAUDE CHECKS PASSED")
    log.info("=" * 70)
