0BAB1/HOLY_CORE_COURSE/3_perf_edition/example_programs/ethernet_dma/fft.c

#include "fft.h"

// Q1.15 twiddle factors: cos(2*pi*k/256) and -sin(2*pi*k/256), k=0..127
// generated with:
//   import math; N=256
//   for k in range(N//2): print(f"{int(math.cos(2*math.pi*k/N)*32767)},{int(-math.sin(2*math.pi*k/N)*32767)},")
static const int16_t tw_re[128] = {
 32767, 32757, 32728, 32678, 32609, 32520, 32412, 32285,
 32137, 31970, 31785, 31580, 31356, 31113, 30852, 30571,
 30273, 29956, 29621, 29268, 28898, 28510, 28105, 27683,
 27245, 26790, 26319, 25832, 25329, 24811, 24278, 23731,
 23170, 22594, 22005, 21403, 20787, 20159, 19519, 18868,
 18204, 17530, 16846, 16151, 15446, 14732, 14010, 13279,
 12539, 11793, 11039, 10278,  9512,  8739,  7962,  7179,
  6393,  5602,  4808,  4011,  3212,  2410,  1608,   804,
     0,  -804, -1608, -2410, -3212, -4011, -4808, -5602,
 -6393, -7179, -7962, -8739, -9512,-10278,-11039,-11793,
-12539,-13279,-14010,-14732,-15446,-16151,-16846,-17530,
-18204,-18868,-19519,-20159,-20787,-21403,-22005,-22594,
-23170,-23731,-24278,-24811,-25329,-25832,-26319,-26790,
-27245,-27683,-28105,-28510,-28898,-29268,-29621,-29956,
-30273,-30571,-30852,-31113,-31356,-31580,-31785,-31970,
-32137,-32285,-32412,-32520,-32609,-32678,-32728,-32757,
};

static const int16_t tw_im[128] = {
     0,  -804, -1608, -2410, -3212, -4011, -4808, -5602,
 -6393, -7179, -7962, -8739, -9512,-10278,-11039,-11793,
-12539,-13279,-14010,-14732,-15446,-16151,-16846,-17530,
-18204,-18868,-19519,-20159,-20787,-21403,-22005,-22594,
-23170,-23731,-24278,-24811,-25329,-25832,-26319,-26790,
-27245,-27683,-28105,-28510,-28898,-29268,-29621,-29956,
-30273,-30571,-30852,-31113,-31356,-31580,-31785,-31970,
-32137,-32285,-32412,-32520,-32609,-32678,-32728,-32757,
-32767,-32757,-32728,-32678,-32609,-32520,-32412,-32285,
-32137,-31970,-31785,-31580,-31356,-31113,-30852,-30571,
-30273,-29956,-29621,-29268,-28898,-28510,-28105,-27683,
-27245,-26790,-26319,-25832,-25329,-24811,-24278,-23731,
-23170,-22594,-22005,-21403,-20787,-20159,-19519,-18868,
-18204,-17530,-16846,-16151,-15446,-14732,-14010,-13279,
-12539,-11793,-11039,-10278, -9512, -8739, -7962, -7179,
 -6393, -5602, -4808, -4011, -3212, -2410, -1608,  -804,
};

// bit reversal for N=256 (8 bits)
static uint8_t bit_reverse_8(uint8_t x) {
    x = ((x & 0xF0) >> 4) | ((x & 0x0F) << 4);
    x = ((x & 0xCC) >> 2) | ((x & 0x33) << 2);
    x = ((x & 0xAA) >> 1) | ((x & 0x55) << 1);
    return x;
}

void fft(int32_t* re, int32_t* im) {
    // bit reversal permutation
    for (int i = 0; i < FFT_N; i++) {
        int j = bit_reverse_8((uint8_t)i);
        if (i < j) {
            int32_t tmp;
            tmp = re[i]; re[i] = re[j]; re[j] = tmp;
            tmp = im[i]; im[i] = im[j]; im[j] = tmp;
        }
    }

    // FFT stages
    for (int stage = 1; stage <= FFT_BITS; stage++) {
        int span    = 1 << (stage - 1);   // butterfly half-span
        int step    = span << 1;           // full butterfly span
        int tw_step = 128 >> (stage - 1);  // twiddle stride

        for (int k = 0; k < span; k++) {
            int32_t wr = tw_re[k * tw_step];
            int32_t wi = tw_im[k * tw_step];

            for (int i = k; i < FFT_N; i += step) {
                int j = i + span;

                // butterfly — Q1.15 multiply: (a * b) >> 15
                int32_t tr = (int32_t)(((int64_t)wr * re[j] - (int64_t)wi * im[j]) >> 15);
                int32_t ti = (int32_t)(((int64_t)wr * im[j] + (int64_t)wi * re[j]) >> 15);

                re[j] = re[i] - tr;
                im[j] = im[i] - ti;
                re[i] = re[i] + tr;
                im[i] = im[i] + ti;
            }
        }
    }
}

void fft_magnitude(int32_t* re, int32_t* im, int32_t* out) {
    for (int i = 0; i < FFT_N / 2; i++) {
        // magnitude squared — avoids sqrt, fine for display
        int64_t mag = ((int64_t)re[i] * re[i]) + ((int64_t)im[i] * im[i]);
        // shift down to fit in int32
        out[i] = (int32_t)(mag >> 15);
    }
}
