0BAB1/HOLY_CORE_COURSE/(commit log)

2024-10-30 corrected : no clk in alu for tb
    [alu.sv]
2024-10-30 fixed stuff, added sign extender
    [signext.sv]
2024-11-05 save (bug to fix on auipc and lui)
    [control.sv, cpu.sv, signext.sv]
2024-11-06 fixed bug ! now sleep
    [cpu.sv]
2024-11-11 added jalr + fixed control bug + updated test bench
    [control.sv, cpu.sv]
2024-11-16 fixed pytest and imports
    [control.sv, holy_core_pkg.sv]
2024-11-25 all holy tb reworked around new test harness, save
    [test_holy_core.py]
2024-12-04 minor fixes to integrate bug tests to tb
    [axi_translator.sv, test_holy_core.py]
2024-12-11 added file header, cleanup ,fixed cache tb, made vivado automation GENERIC, better programs
    [alu.sv, axi_details.sv, axi_translator.sv, constraints.xdc, control.sv, cpu.sv, external_req_arbitrer.sv, holy_core.sv]
2024-12-15 fixed pkg declaration typo in single cycle edition
    [alu.sv, control.sv, holy_core_pkg.sv, load_store_decoder.sv, reader.sv]
2025-03-16 Fixed width error in case statement in the signext.sv on the md file of single_sycle_ed
2025-05-23 finally, CSR works. fixed VERY CRITICAL BUGS AS WELL ! TOdo tomrrow : add comments in file headers, update the docs.
    [axi_details.sv, control.sv, holy_core.sv, holy_wrapper.v, test_holy_core.py]
2025-05-25 BIG COMMIT, working axilite non cachable, moving on to UART tests
2025-05-30 added exmaple sofware using BMP280 IIC Presuure Sensor
2025-06-09 save, worked on drivers, still buggy af
    [holy_core_soc.h, holycore.c, holycore.h, main.c]
2025-06-11 sacfold simpler data IF, not test, currently on work computer doing this instead of waging
2025-06-21 back at it, resetted up the testing env and added direction in readme
    [alu.sv, control.sv, holy_data_no_cache.sv]
2025-06-22 couple of fixes
2025-07-06 HOLY CORE F after interrupt core changes - ready to moe further in interrupt support
2025-07-24 save, sucessfully tested basic interrupts scenarios, goals is to test expcetions and test ricof / fpga
2025-07-25 trap testing now runs but fails miserably
    [test_holy_core.py]
2025-07-29 passing acall, ebreak and misaligned branches test for privileged. Almost there !!
    [alu.sv, control.sv, csr_file.sv, holy_core.sv, holy_core_pkg.sv, test_holy_core.py]
2025-07-29 passing misaligned jumps. "only" L/S remaining.
    [control.sv, csr_file.sv, holy_core.sv]
2025-08-05 save, platform is NOT working and interrupts are buggy, most prob a platform bug in vivado
    [axi_details.sv, constraints.xdc, csr_file.sv, holy_clint_top.v, holy_clint_wrapper.sv, holy_core_soc.h, holy_plic.sv, holy_plic_top.v]
2025-08-06 Success ful UART interrupt support on HOLY PLATFORM !!!!
2025-09-02 added BASYS3 fpga board to exmaple SoC support
2025-09-05 save, still "unsupported error" bruh like fuck you
    [constraints.xdc, external_req_arbitrer.sv, holy_core.sv, holy_data_cache.sv, holy_test_harness.sv, holy_top.sv, holy_top.v, test_holy_core.py]
2025-09-11 save, gotta figure out memory bus problems for debug support
    [constraints.xdc, holy_core.sv, holy_top.sv, test_run_lint.py]
2025-09-11 add cfg + save tinkering for debug mode impl
    [holy_core_openocd.cfg]
2025-09-17 save - debug works !! But... not really and test don't pass lol
    [holy_core_openocd.cfg]
2025-09-18 save, debug sba still not working
    [holy_core_openocd.cfg]
2025-09-22 fixed data cache latching init fpga bug
    [holy_core_pkg.sv, holy_data_cache.sv, holy_top.sv, holy_top.v]
2025-09-24 on chip debugging finally works !
    [holy_core_openocd.cfg]
2025-09-25 re-ran compliance tests on debuggable core - passed
    [holy_core_openocd.cfg]
2025-09-26 fixed fence exception bug
    [control.sv, holy_core_pkg.sv]
2025-10-06 Revert "add DDR RAM SUPPORT on arty FPGA"
    This reverts commit b079c414ced7c40b727b30f3e4df833957631d0a.
    [constraints.xdc, holy_core_soc.h, holy_top.sv, holy_top.v, holycore.c, main.c]
2025-10-07 Added DDR3 SDRAM support on arty boards. Got rid of bootloaders.
2025-10-21 re-organized SoC, added a bot rom (loop by default), fixed interrupt handling, and fixed a lw edge case bug
    [holy_core_openocd.cfg]
2025-11-18 DOOM running in UART (No IO, only proves compiling + valid frame)
2025-11-18 Revert "DOOM running in UART (No IO, only proves compiling + valid frame)"
    This reverts commit 08d02bb2e915f5a02a1e09e467cffc2688385424.
    [holy_core_soc.h, holy_top.sv, holy_top.v, holycore.c, main.c]
2025-11-19 bug fix for valid flag on simple instr cache
    [holy_data_cache.sv]
2025-11-21 about to start performance edition
    [dump.txt, holy_core_openocd.cfg]
2025-11-22 dumped performance edition
    [dump.txt, holy_core_openocd.cfg]
2025-11-22 re-added perf edtion, renamed I cache, Sketched a *supposedly* mor perfomant data chache. todo : implement it and test doom as benchmark
    [holy_core_openocd.cfg]
2025-11-23 save, container doesn't really work
    [test_holy_core.py, test_holy_instr_cache.py]
2025-11-26 somewhat working data cache. Won't implement yet, passes RISCOF tho
    [axi_translator.sv, external_req_arbitrer.sv, holy_core.sv, holy_core_pkg.sv, holy_data_cache.sv, holy_no_cache.sv, test_external_req_arbitrer.py, test_holy_core.py]
2025-11-28 works but not really, still weird bugs to fix and instr cache to cleanup
    [constraints.xdc, control.sv, csr_file.sv, external_req_arbitrer.sv, holy_core.sv, holy_core_pkg.sv, holy_data_cache.sv]
2025-12-19 BUG FIX : I$ + Debug mode timings
    [control.sv, csr_file.sv, holy_core.sv, holy_top.sv, holy_top.v, main.c, test_holy_core.py]
2025-12-19 D$ fixed and passed FPGA stress tests. The core is now "known bug" free.
    [holy_core.sv, holy_data_cache.sv, main.c, test_run_lint.py]
2026-01-05 better I$ tests, screen bug still to be found
    [holy_core.sv, test_holy_instr_cache.py]
2026-01-05 turns out there was no I$ bug. well, at least the tests are way more robust now. (coping)
    [csr_file.sv, holy_core.sv, main.c, test_run_lint.py]
2026-03-17 [BOARD SUPPORT] Add kc705 board support on VIVADO + Openocd debug
    [hc_kc705.cfg]
2026-03-18 [EXAMPLE SW] Ethernet DMA program demo
2026-04-13 Optimize memory reset logic by removing duplicate loop
    Remove redundant initialization loop for memory reset
    [memory.sv]
2026-04-13 Replace display error by fatal error for misaligned write
    Instead of just printing out an error message, we should generally raise an exception to stop an incorrect program from executing further
    [memory.sv]
2026-07-13 fix(control): prevent latch inference and correct alu_control default
    - Both always_comb blocks in the main and ALU decoders lacked default
    assignments at the top, leaving several outputs undriven on some case
    branches (second_add_source, alu_op, alu_source in the main decoder;
    alu_control in the ALU decoder when func7 matches neither F7_SLL_SRL
    nor F7_SRA in the F3_SRL_SRA arm). This risks latch inference during
    synthesis.
    - Add safe default assignments (0) at the top of each block before the
    case statement.
    - Also replace alu_control's default value of 4'b1111, which is not
    defined in alu_control_t, with ALU_ADD. This case is a don't-care
    since reg_write/mem_write are alr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
    [control.sv]
2026-07-18 removed deprecated @coroutine decorators across all files + replaced unknown initialised values to default to all 1s
    [test_glue_logic.py, test_holy_core.py, test_holy_data_cache.py]
2026-07-23 [single-cycle] fix(memory): correct $fatal syntax and add read-path alignment check
    - Explicitly define a storage type for `WORDS` (`int`) and `mem_init`
    (`string`) parameter.
    - Use `[WORDS]` shorthand for unpacked array size (equivalent to
    `[0:WORDS-1]`), no functional change.
    - Fix write-path `$fatal` syntax (add `finish_number` = `1`).
    - Add address-misalignment check on the read path (mirrors the existing
    write-path check), with a default drive for `read_data` before the
    check to avoid incomplete combinational assignment on the `$fatal`
    branch.
    [memory.sv]
2026-10-28 Fix data cache edge case bugs. Improve data cache testbench + misc stuff
